pierre-bouckson/GameGirl/PCB/jlcpcb/production_files/BOM-PCB-dos.csv

Comment | Designator | Footprint | LCSC | Quantity
1.5kΩ | R3 | R_0402 | C25867 | 1
100kΩ | R7,R8,R10,R38 | R_0402 | C25741 | 4
100nF | C5,C6,C7,C8,C9,C10,C11,C12,C13,C14,C15,C16,C17,C20,C23,C24,C30,C31,C32,C33,C34,C35,C36,C40,C41,C42,C43,C44,C45,C46,C50 | C_0402 | C1525 | 31
100Ω | R37 | R_0402 | C25076 | 1
10kΩ | R6,R9,R22,R23,R24,R25,R26,R43 | R_0402 | C25744 | 8
10uF | C1,C2,C3,C4,C47 | C_0603 | C19702 | 5
15Ω | R44 | R_0603 | C22810 | 1
1N4148W | D5 | D_SOD-123 | C81598 | 1
1kΩ | R4,R5,R20,R21 | R_0402 | C11702 | 4
1uF | C19 | C_0603 | C15849 | 1
1uF | C53 | C_0805 | C28323 | 1
2.2uF | C21,C22 | C_0603 | C23630 | 2
220nF | C54 | C_0402 | C16772 | 1
4.7uF | C18,C51,C52 | C_0603 | C19666 | 3
5.1kΩ | R1,R2 | R_0402 | C25905 | 2
600Ω@100MHz | FB1 | FB_0603 | C1002 | 1
AO3400A | Q2 | Q_SOT-23 | C20917 | 1
AO3401A | Q1,Q3 | Q_SOT-23 | C15127 | 2
AP2112K-3.3TRG1 | U2 | SOT-25-5_L2.9-W1.6-P0.95-LS2.8-BL | C51118 | 1
B5819W | D1,D4 | D_SOD-123 | C64885 | 2
BATT JST-PH 2 mm | J2 | CONN-SMD_P2.00_S2B-PH-SM4-TB-LF-SN | C295747 | 1
DT024CTFT | J6 | CONN-SMD_FH12-45S-0.5SH-55 | C3168432 | 1
IS42S16400J-7TLI | U5 | TSOP-54_L22.2-W10.2-P0.80-LS11.8-BL | C2979137 | 1
MLT-8530 | BZ1 | BUZ-SMD_4P-L8.5-W8.5-P8.50-BR | C94599 | 1
ON/OFF | SW1 | SW-TH_MSK12C02 | C431540 | 1
Rouge : en charge | D2 | D_0603 | C2286 | 1
STM32F429ZIT6 | U3 | LQFP-144_20x20mm_P0.5mm | C84808 | 1
SWPA4030S100MT | L1 | IND-SMD_L4.0-W4.0 | C38117 | 1
TP4056 | U1 | ESOP-8_L4.9-W3.9-P1.27-LS6.0-BL-EP | C16581 | 1
TPS61165DBVR | U6 | SOT-23-6_L2.9-W1.6-P0.95-LS2.8-BR | C58756 | 1
USB-C 16P | J1 | TYPE-C-SMD_HX-TYPE-C-16PIN | C2927039 | 1
Vert : chargée | D3 | D_0805 | C2297 | 1
