pierre-bouckson/GameGirl/boitier/assemblage.step

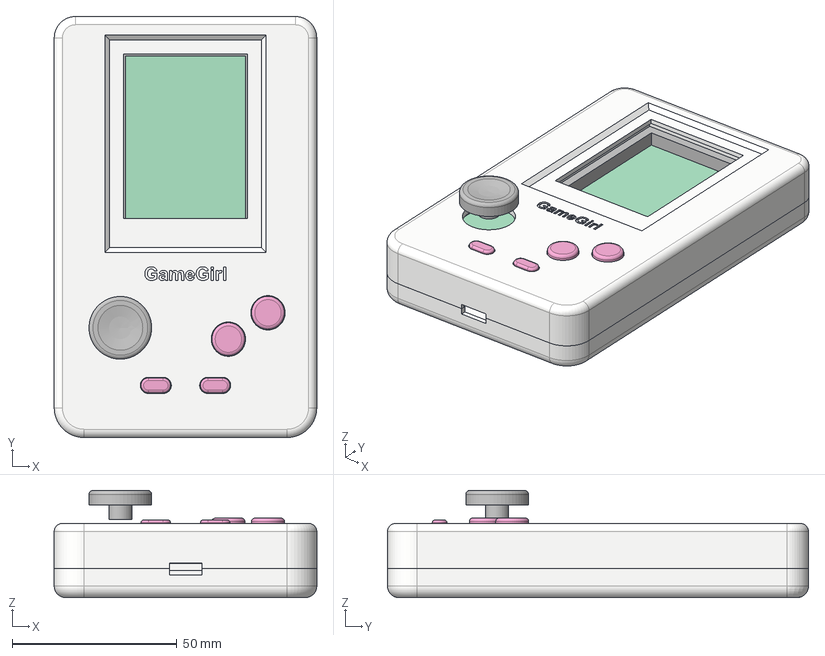
[picture p1: CAD file, 2026-11-11]
boitier/assemblage.step
79.6 x 127.6 x 32.5 mm
coque_avant_part
coque_arriere_part
cale_ecran_part
pcb_part
capuchon_A_part
capuchon_B_part
capuchon_SELECT_part
capuchon_START_part
capuchon_joystick_part
