pierre-bouckson/GameGirl/boitier/cale_ecran.step

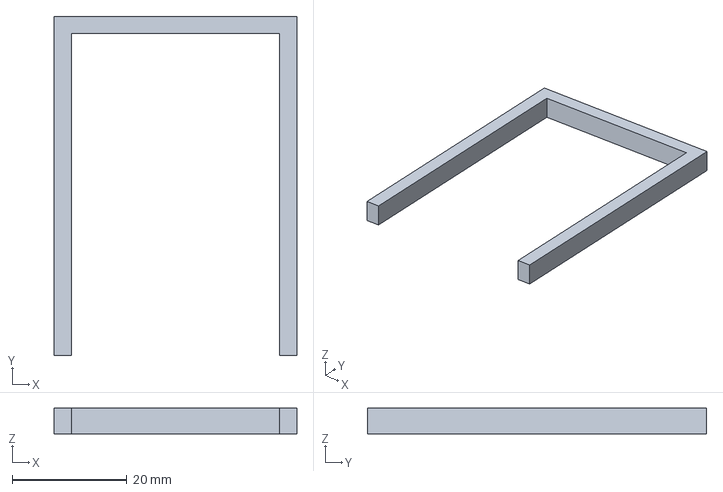
[picture p2: CAD file, 2026-11-11]
boitier/cale_ecran.step
42.3 x 59.1 x 4.50 mm
