pierre-bouckson/GameGirl/boitier/coque_arriere_bambu_lab.3mf

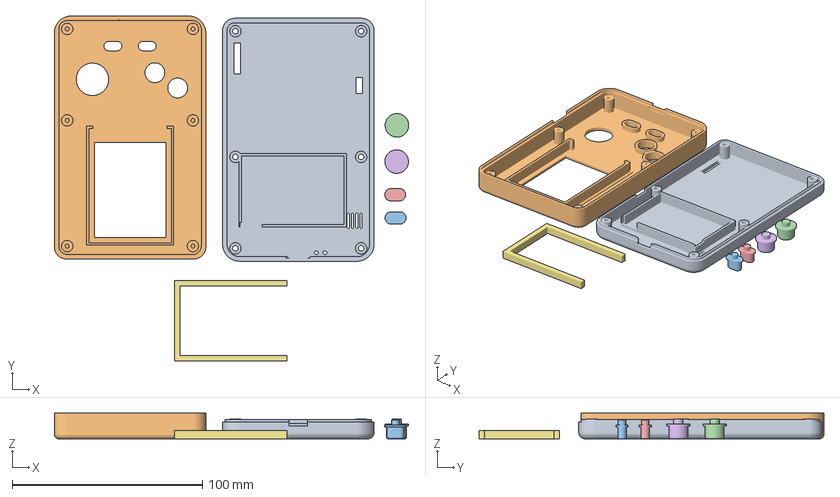
[picture p3: CAD file, 2026-11-11]
boitier/coque_arriere_bambu_lab.3mf
186.1 x 181.1 x 13.6 mm
coque_arriere.stl
coque_avant.stl
capuchon_start_select.stl x 2
capuchon_AB.stl x 2
cale_ecran.stl
