pierre-bouckson/GameGirl/boitier/capuchon_AB.step

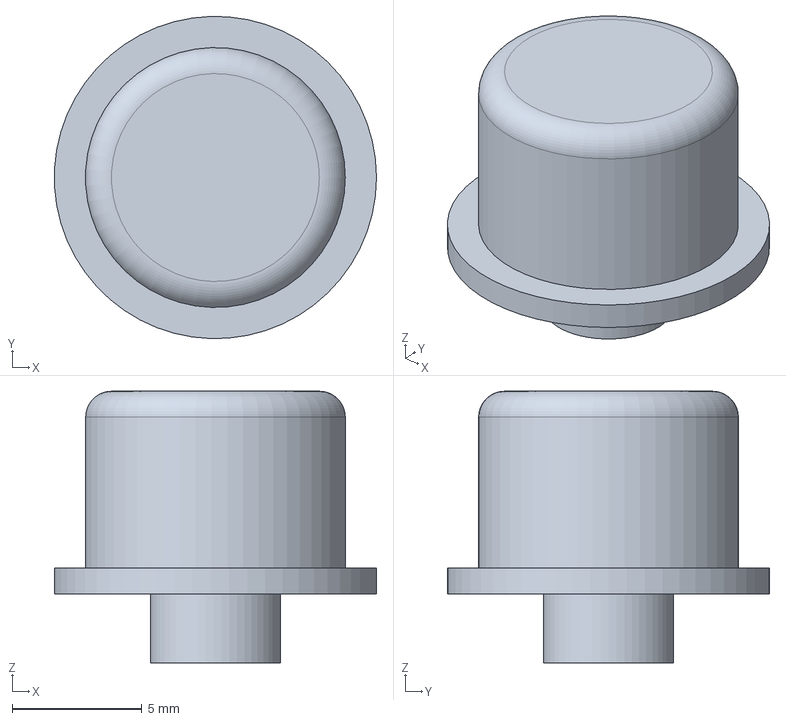
[picture p4: CAD file, 2026-11-11]
boitier/capuchon_AB.step
12.4 x 12.4 x 10.4 mm
