pierre-bouckson/GameGirl/boitier/capuchon_start_select.step

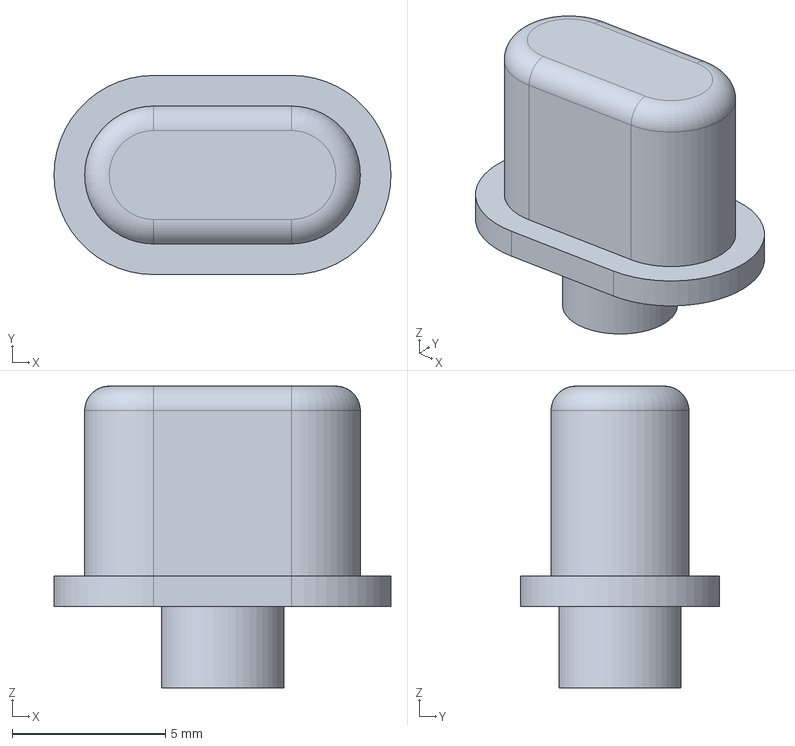
[picture p5: CAD file, 2026-11-11]
boitier/capuchon_start_select.step
11.0 x 6.50 x 9.85 mm
