pierre-bouckson/GameGirl/boitier/coque_avant.step

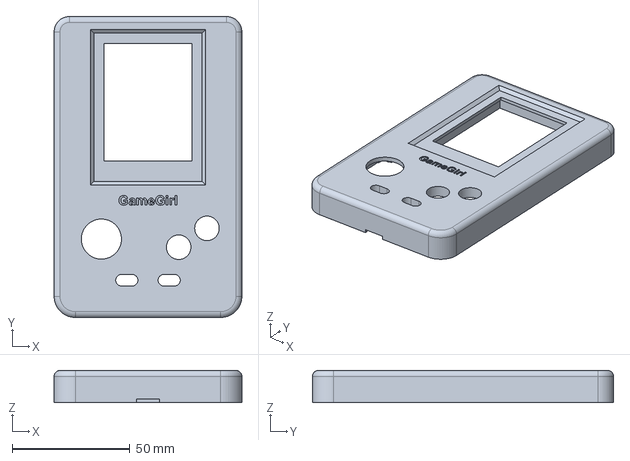
[picture p6: CAD file, 2026-11-11]
boitier/coque_avant.step
79.6 x 127.6 x 13.6 mm
