pierre-bouckson/GameGirl/boitier/coque_arriere.step

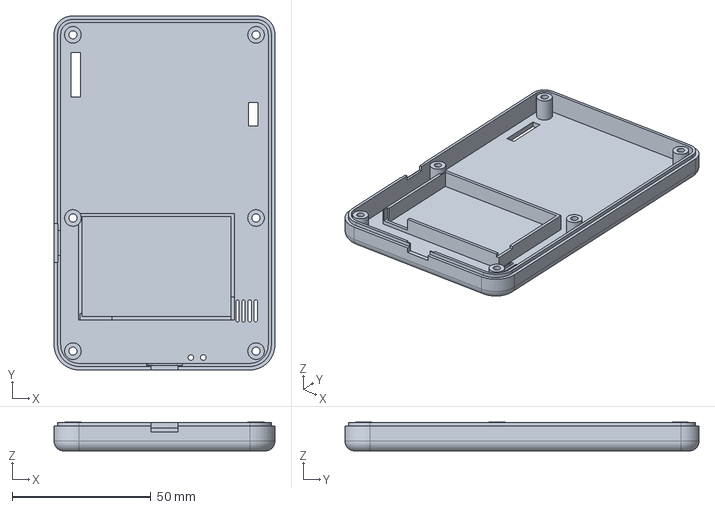
[picture p7: CAD file, 2026-11-11]
boitier/coque_arriere.step
79.6 x 127.6 x 10.4 mm
