pierre-bouckson/GameGirl/boitier/capuchon_joystick.step

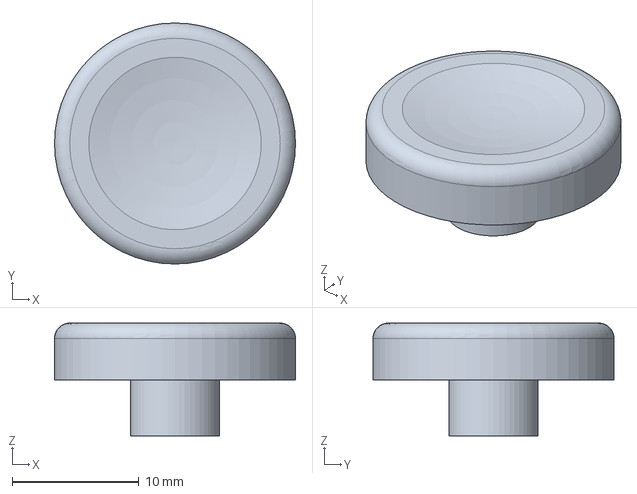
[picture p8: CAD file, 2026-11-11]
boitier/capuchon_joystick.step
19.0 x 19.0 x 8.90 mm
