pierre-bouckson/GameGirl/(list of files, cad)

Other CAD files:
boitier/cale_ecran.stl
boitier/capuchon_AB.stl
boitier/capuchon_joystick.stl
boitier/capuchon_start_select.stl
boitier/coque_arriere.stl
boitier/coque_avant.stl
