pierre-bouckson/GameGirl/PCB/PCB.kicad_pcb

## KiCad design PCB/PCB.kicad_pcb (2026-11-11)

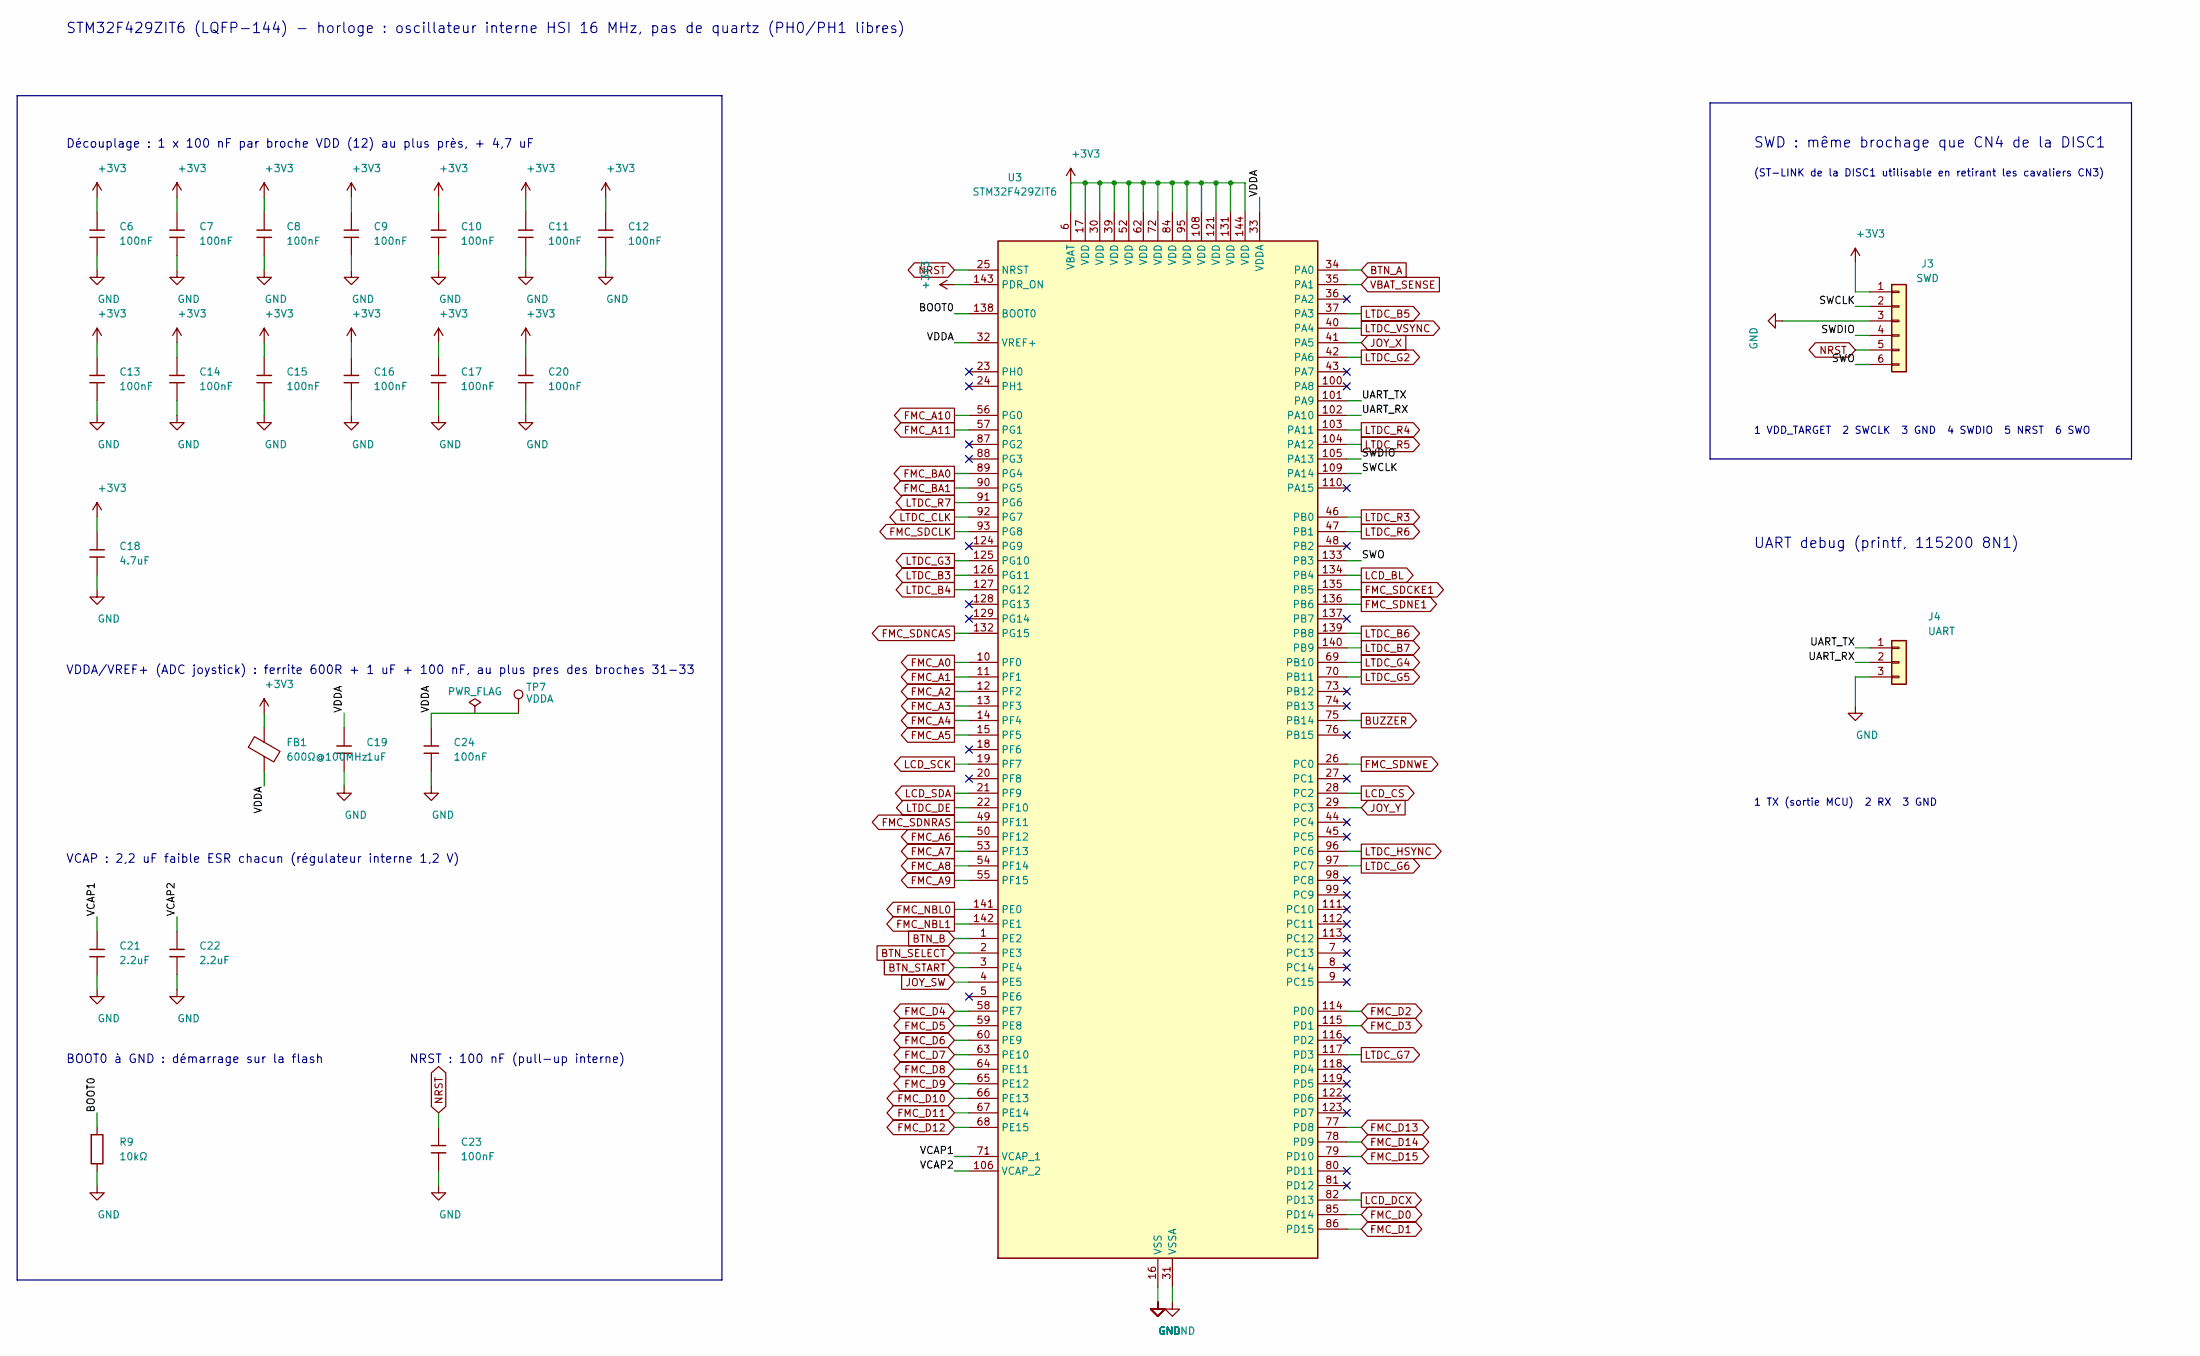
[picture p9: schematic mcu.kicad_sch, GameGirl - MCU]

Parts:
C6, C7, C8, C9, C10, C11, C12, C13, C14, C15, C16, C17, C20, C23, C24: 100nF; C_0402; LCSC C1525
C18: 4.7uF; C_0603; LCSC C19666
C19: 1uF; C_0603; LCSC C15849
C21, C22: 2.2uF; C_0603; LCSC C23630
FB1: 600Ω@100MHz; FB_0603; LCSC C1002
J3: SWD; PinHeader_1x06_P2.54mm_Vertical
J4: UART; PinHeader_1x03_P2.54mm_Vertical
R9: 10kΩ; R_0402; LCSC C25744
TP7: VDDA; TestPoint_Pad_D1.5mm
U3: STM32F429ZIT6; LQFP-144_20x20mm_P0.5mm; LCSC C84808

Connections:
+3V3: C6.1, C7.1, C8.1, C9.1, C10.1, C11.1, C12.1, C13.1, C14.1, C15.1, C16.1, C17.1, C18.1, C20.1, FB1.1, J3.1, U3.6 (VBAT), U3.17 (VDD), U3.30 (VDD), U3.39 (VDD), U3.52 (VDD), U3.62 (VDD), U3.72 (VDD), U3.84 (VDD), U3.95 (VDD), U3.108 (VDD), U3.121 (VDD), U3.131 (VDD), U3.143 (PDR_ON), U3.144 (VDD); also elsewhere on the board
/MCU/BOOT0: R9.1, U3.138 (BOOT0)
/MCU/SWCLK: J3.2, U3.109 (PA14)
/MCU/SWDIO: J3.4, U3.105 (PA13)
/MCU/SWO: J3.6, U3.133 (PB3)
/MCU/UART_RX: J4.2, U3.102 (PA10)
/MCU/UART_TX: J4.1, U3.101 (PA9)
/MCU/VCAP1: C21.1, U3.71 (VCAP_1)
/MCU/VCAP2: C22.1, U3.106 (VCAP_2)
/MCU/VDDA: C19.1, C24.1, FB1.2, TP7.1, U3.32 (VREF+), U3.33 (VDDA)
BTN_A: U3.34 (PA0); also elsewhere on the board
BTN_B: U3.1 (PE2); also elsewhere on the board
BTN_SELECT: U3.2 (PE3); also elsewhere on the board
BTN_START: U3.3 (PE4); also elsewhere on the board
BUZZER: U3.75 (PB14); also elsewhere on the board
FMC_A0: U3.10 (PF0); also elsewhere on the board
FMC_A1: U3.11 (PF1); also elsewhere on the board
FMC_A2: U3.12 (PF2); also elsewhere on the board
FMC_A3: U3.13 (PF3); also elsewhere on the board
FMC_A4: U3.14 (PF4); also elsewhere on the board
FMC_A5: U3.15 (PF5); also elsewhere on the board
FMC_A6: U3.50 (PF12); also elsewhere on the board
FMC_A7: U3.53 (PF13); also elsewhere on the board
FMC_A8: U3.54 (PF14); also elsewhere on the board
FMC_A9: U3.55 (PF15); also elsewhere on the board
FMC_A10: U3.56 (PG0); also elsewhere on the board
FMC_A11: U3.57 (PG1); also elsewhere on the board
FMC_BA0: U3.89 (PG4); also elsewhere on the board
FMC_BA1: U3.90 (PG5); also elsewhere on the board
FMC_D0: U3.85 (PD14); also elsewhere on the board
FMC_D1: U3.86 (PD15); also elsewhere on the board
FMC_D2: U3.114 (PD0); also elsewhere on the board
FMC_D3: U3.115 (PD1); also elsewhere on the board
FMC_D4: U3.58 (PE7); also elsewhere on the board
FMC_D5: U3.59 (PE8); also elsewhere on the board
FMC_D6: U3.60 (PE9); also elsewhere on the board
FMC_D7: U3.63 (PE10); also elsewhere on the board
FMC_D8: U3.64 (PE11); also elsewhere on the board
FMC_D9: U3.65 (PE12); also elsewhere on the board
FMC_D10: U3.66 (PE13); also elsewhere on the board
FMC_D11: U3.67 (PE14); also elsewhere on the board
FMC_D12: U3.68 (PE15); also elsewhere on the board
FMC_D13: U3.77 (PD8); also elsewhere on the board
FMC_D14: U3.78 (PD9); also elsewhere on the board
FMC_D15: U3.79 (PD10); also elsewhere on the board
FMC_NBL0: U3.141 (PE0); also elsewhere on the board
FMC_NBL1: U3.142 (PE1); also elsewhere on the board
FMC_SDCKE1: U3.135 (PB5); also elsewhere on the board
FMC_SDCLK: U3.93 (PG8); also elsewhere on the board
FMC_SDNCAS: U3.132 (PG15); also elsewhere on the board
FMC_SDNE1: U3.136 (PB6); also elsewhere on the board
FMC_SDNRAS: U3.49 (PF11); also elsewhere on the board
FMC_SDNWE: U3.26 (PC0); also elsewhere on the board
GND: C6.2, C7.2, C8.2, C9.2, C10.2, C11.2, C12.2, C13.2, C14.2, C15.2, C16.2, C17.2, C18.2, C19.2, C20.2, C21.2, C22.2, C23.2, C24.2, J3.3, J4.3, R9.2, U3.16 (VSS), U3.31 (VSSA), U3.38 (VSS), U3.51 (VSS), U3.61 (VSS), U3.83 (VSS), U3.94 (VSS), U3.107 (VSS), U3.120 (VSS), U3.130 (VSS); also elsewhere on the board
JOY_SW: U3.4 (PE5); also elsewhere on the board
JOY_X: U3.41 (PA5); also elsewhere on the board
JOY_Y: U3.29 (PC3); also elsewhere on the board
LCD_BL: U3.134 (PB4); also elsewhere on the board
LCD_CS: U3.28 (PC2); also elsewhere on the board
LCD_DCX: U3.82 (PD13); also elsewhere on the board
LCD_SCK: U3.19 (PF7); also elsewhere on the board
LCD_SDA: U3.21 (PF9); also elsewhere on the board
LTDC_B3: U3.126 (PG11); also elsewhere on the board
LTDC_B4: U3.127 (PG12); also elsewhere on the board
LTDC_B5: U3.37 (PA3); also elsewhere on the board
LTDC_B6: U3.139 (PB8); also elsewhere on the board
LTDC_B7: U3.140 (PB9); also elsewhere on the board
LTDC_CLK: U3.92 (PG7); also elsewhere on the board
LTDC_DE: U3.22 (PF10); also elsewhere on the board
LTDC_G2: U3.42 (PA6); also elsewhere on the board
LTDC_G3: U3.125 (PG10); also elsewhere on the board
LTDC_G4: U3.69 (PB10); also elsewhere on the board
LTDC_G5: U3.70 (PB11); also elsewhere on the board
LTDC_G6: U3.97 (PC7); also elsewhere on the board
LTDC_G7: U3.117 (PD3); also elsewhere on the board
LTDC_HSYNC: U3.96 (PC6); also elsewhere on the board
LTDC_R3: U3.46 (PB0); also elsewhere on the board
LTDC_R4: U3.103 (PA11); also elsewhere on the board
LTDC_R5: U3.104 (PA12); also elsewhere on the board
LTDC_R6: U3.47 (PB1); also elsewhere on the board
LTDC_R7: U3.91 (PG6); also elsewhere on the board
LTDC_VSYNC: U3.40 (PA4); also elsewhere on the board
NRST: C23.1, J3.5, U3.25 (NRST); also elsewhere on the board
VBAT_SENSE: U3.35 (PA1); also elsewhere on the board

Notes on the sheet:
(ST-LINK de la DISC1 utilisable en retirant les cavaliers CN3)
BOOT0 à GND : démarrage sur la flash
1 VDD_TARGET 2 SWCLK 3 GND 4 SWDIO 5 NRST 6 SWO
SWD : même brochage que CN4 de la DISC1
NRST : 100 nF (pull-up interne)
Découplage : 1 x 100 nF par broche VDD (12) au plus près, + 4,7 uF
VCAP : 2,2 uF faible ESR chacun (régulateur interne 1,2 V)
STM32F429ZIT6 (LQFP-144) - horloge : oscillateur interne HSI 16 MHz, pas de quartz (PH0/PH1 libres)
VDDA/VREF+ (ADC joystick) : ferrite 600R + 1 uF + 100 nF, au plus pres des broches 31-33
UART debug (printf, 115200 8N1)
1 TX (sortie MCU) 2 RX 3 GND

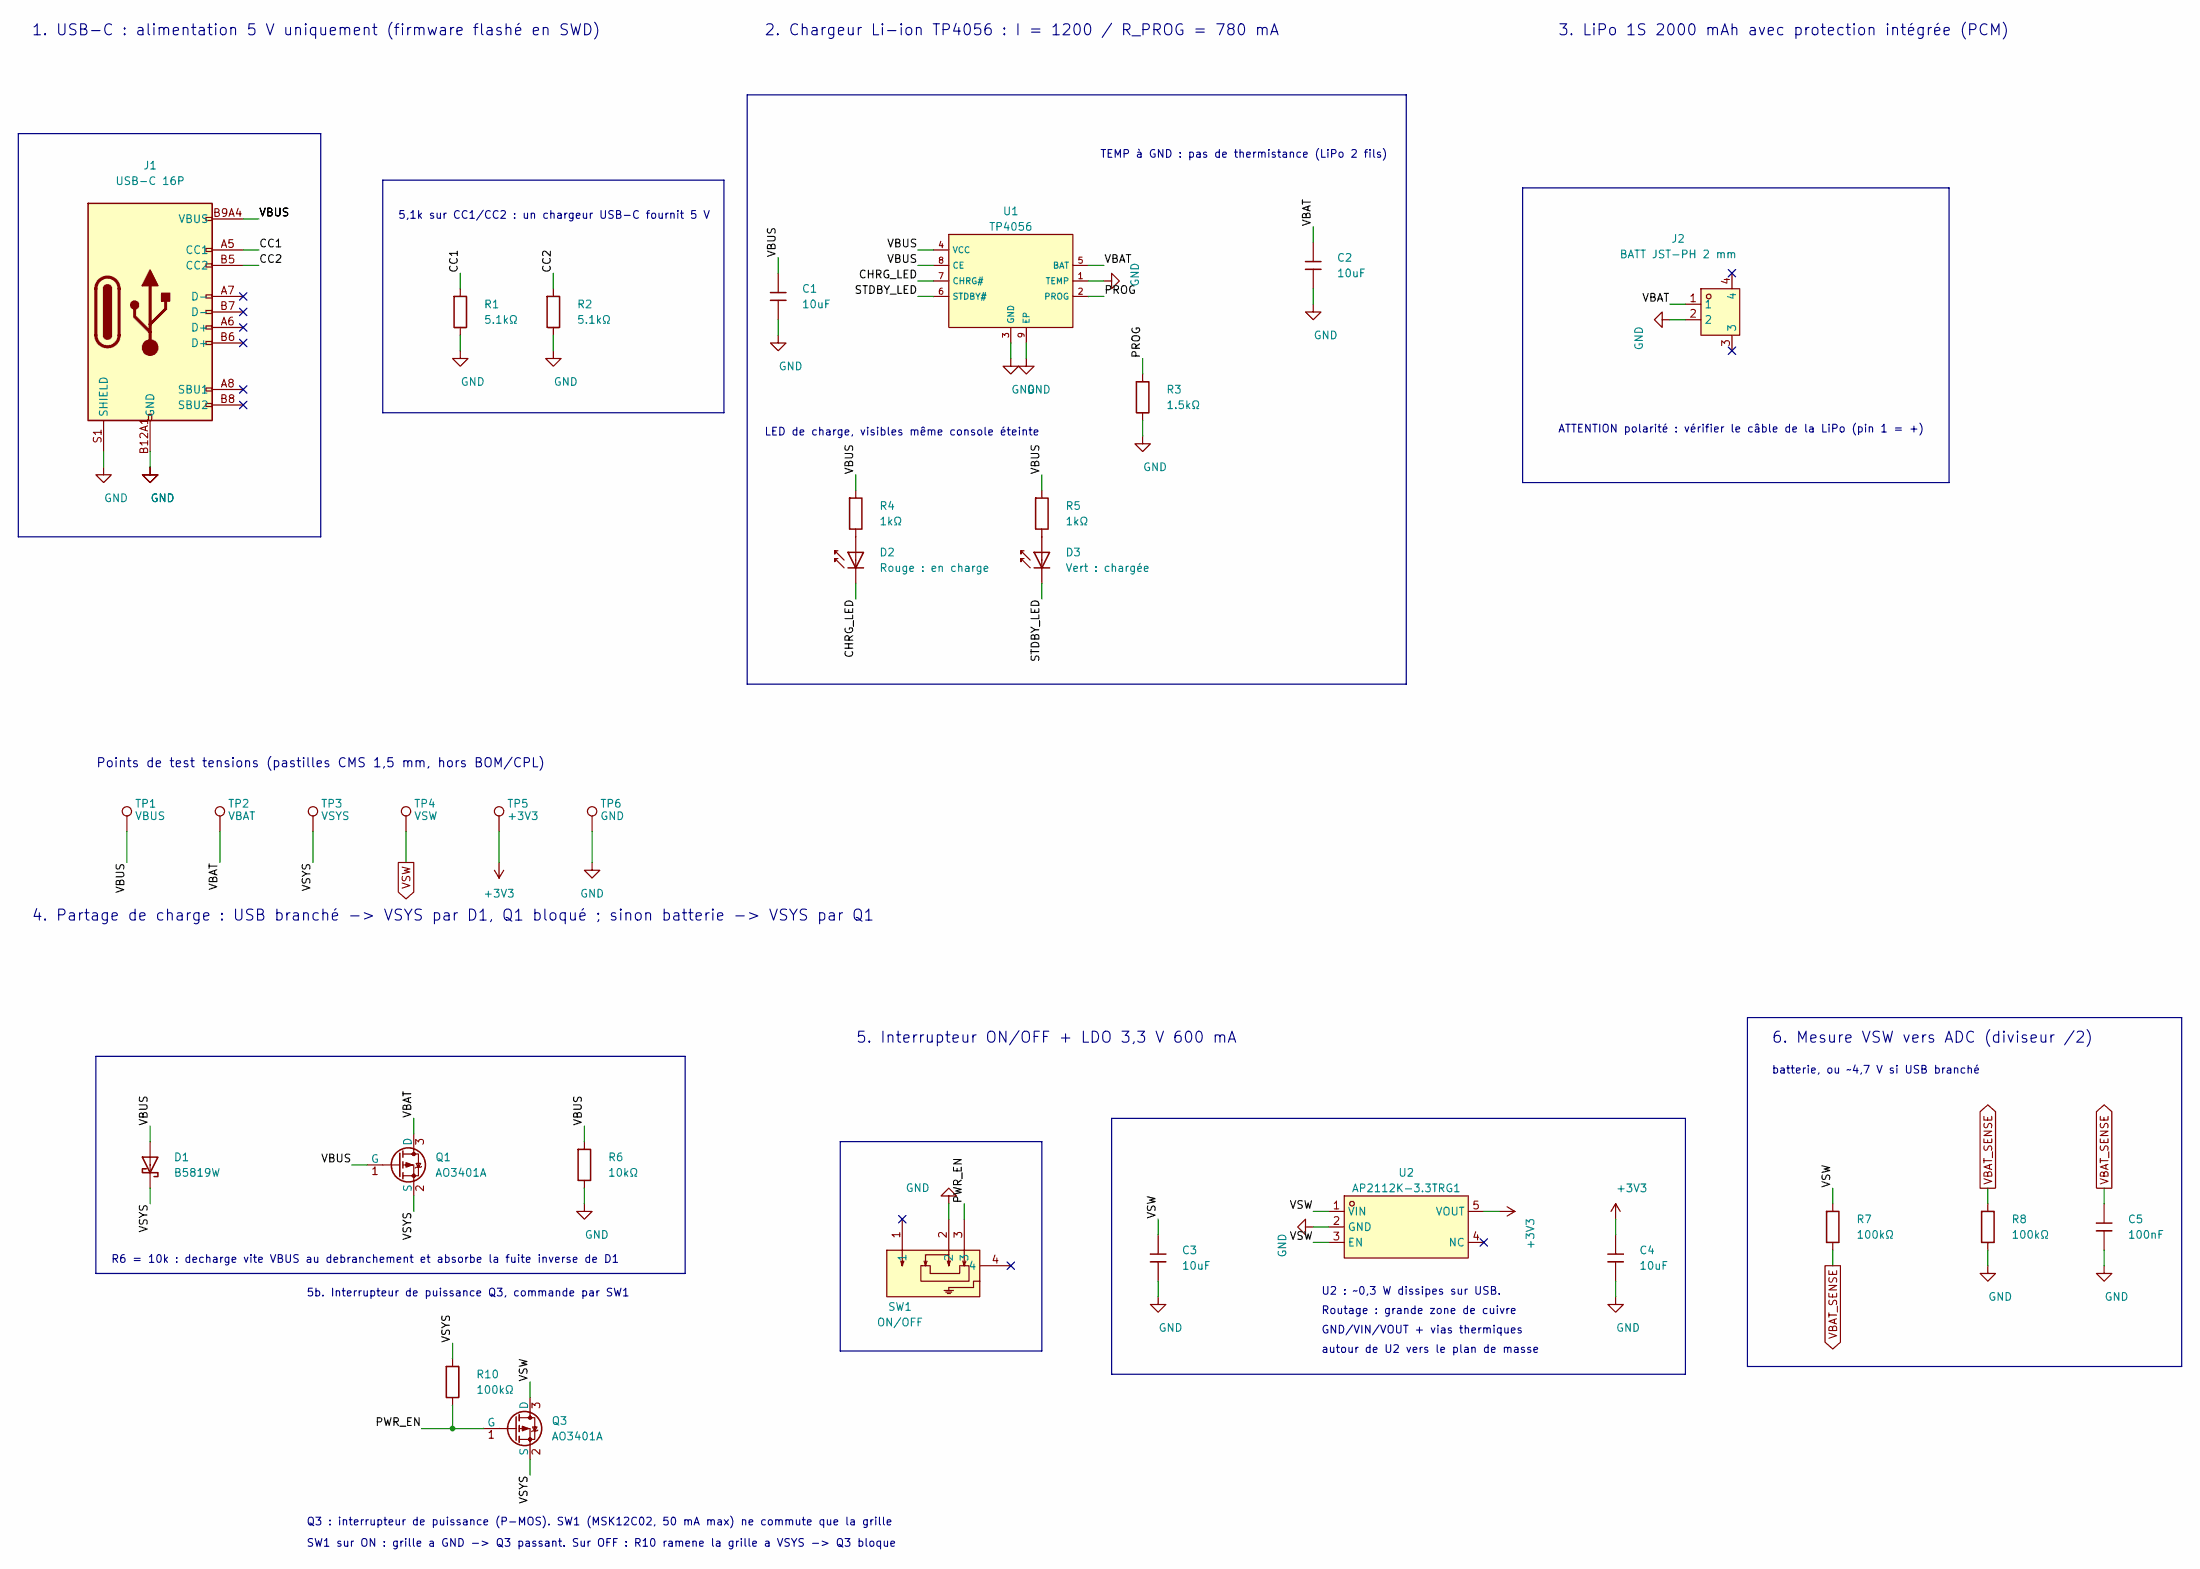
[picture p10: schematic power.kicad_sch, GameGirl - Alimentation]

Parts:
C1, C2, C3, C4: 10uF; C_0603; LCSC C19702
C5: 100nF; C_0402; LCSC C1525
D1: B5819W; D_SOD-123; LCSC C64885
D2: Rouge : en charge; D_0603; LCSC C2286
D3: Vert : chargée; D_0805; LCSC C2297
J1: USB-C 16P; TYPE-C-SMD_HX-TYPE-C-16PIN; LCSC C2927039
J2: BATT JST-PH 2 mm; CONN-SMD_P2.00_S2B-PH-SM4-TB-LF-SN; LCSC C295747
Q1, Q3: AO3401A; Q_SOT-23; LCSC C15127
R1, R2: 5.1kΩ; R_0402; LCSC C25905
R3: 1.5kΩ; R_0402; LCSC C25867
R4, R5: 1kΩ; R_0402; LCSC C11702
R6: 10kΩ; R_0402; LCSC C25744
R7, R8, R10: 100kΩ; R_0402; LCSC C25741
SW1: ON/OFF; SW-TH_MSK12C02; LCSC C431540
TP1: VBUS; TestPoint_Pad_D1.5mm
TP2: VBAT; TestPoint_Pad_D1.5mm
TP3: VSYS; TestPoint_Pad_D1.5mm
TP4: VSW; TestPoint_Pad_D1.5mm
TP5: +3V3; TestPoint_Pad_D1.5mm
TP6: GND; TestPoint_Pad_D1.5mm
U1: TP4056; ESOP-8_L4.9-W3.9-P1.27-LS6.0-BL-EP; LCSC C16581
U2: AP2112K-3.3TRG1; SOT-25-5_L2.9-W1.6-P0.95-LS2.8-BL; LCSC C51118

Connections:
+3V3: C4.1, TP5.1, U2.5 (VOUT); also elsewhere on the board
/Alimentation/CC1: J1.A5 (CC1), R1.1
/Alimentation/CC2: J1.B5 (CC2), R2.1
/Alimentation/CHRG_LED: D2.1, U1.7 (CHRG#)
/Alimentation/PROG: R3.1, U1.2 (PROG)
/Alimentation/PWR_EN: Q3.1 (G), R10.2, SW1.3
/Alimentation/STDBY_LED: D3.1, U1.6 (STDBY#)
/Alimentation/VBAT: C2.1, J2.1, Q1.3 (D), TP2.1, U1.5 (BAT)
/Alimentation/VBUS: C1.1, D1.2, J1.A9B4 (VBUS), J1.B9A4 (VBUS), Q1.1 (G), R4.1, R5.1, R6.1, TP1.1, U1.4 (VCC), U1.8 (CE)
/Alimentation/VSYS: D1.1, Q1.2 (S), Q3.2 (S), R10.1, TP3.1
GND: C1.2, C2.2, C3.2, C4.2, C5.2, J1.A12B1 (GND), J1.B12A1 (GND), J1.S1 (SHIELD), J2.2, R1.2, R2.2, R3.2, R6.2, R8.2, SW1.2, TP6.1, U1.1 (TEMP), U1.3 (GND), U1.9 (EP), U2.2 (GND); also elsewhere on the board
unnamed: D2.2, R4.2
unnamed: D3.2, R5.2
VBAT_SENSE: C5.1, R7.2, R8.1; also elsewhere on the board
VSW: C3.1, Q3.3 (D), R7.1, TP4.1, U2.1 (VIN), U2.3 (EN); also elsewhere on the board

Notes on the sheet:
3. LiPo 1S 2000 mAh avec protection intégrée (PCM)
5. Interrupteur ON/OFF + LDO 3,3 V 600 mA
TEMP à GND : pas de thermistance (LiPo 2 fils)
ATTENTION polarité : vérifier le câble de la LiPo (pin 1 = +)
4. Partage de charge : USB branché -> VSYS par D1, Q1 bloqué ; sinon batterie -> VSYS par Q1
5,1k sur CC1/CC2 : un chargeur USB-C fournit 5 V
1. USB-C : alimentation 5 V uniquement (firmware flashé en SWD)
LED de charge, visibles même console éteinte
batterie, ou ~4,7 V si USB branché
6. Mesure VSW vers ADC (diviseur /2)
2. Chargeur Li-ion TP4056 : I = 1200 / R_PROG = 780 mA
Points de test tensions (pastilles CMS 1,5 mm, hors BOM/CPL)
U2 : ~0,3 W dissipes sur USB.
Routage : grande zone de cuivre
GND/VIN/VOUT + vias thermiques
autour de U2 vers le plan de masse
5b. Interrupteur de puissance Q3, commande par SW1
Q3 : interrupteur de puissance (P-MOS). SW1 (MSK12C02, 50 mA max) ne commute que la grille
SW1 sur ON : grille a GND -> Q3 passant. Sur OFF : R10 ramene la grille a VSYS -> Q3 bloque
R6 = 10k : decharge vite VBUS au debranchement et absorbe la fuite inverse de D1

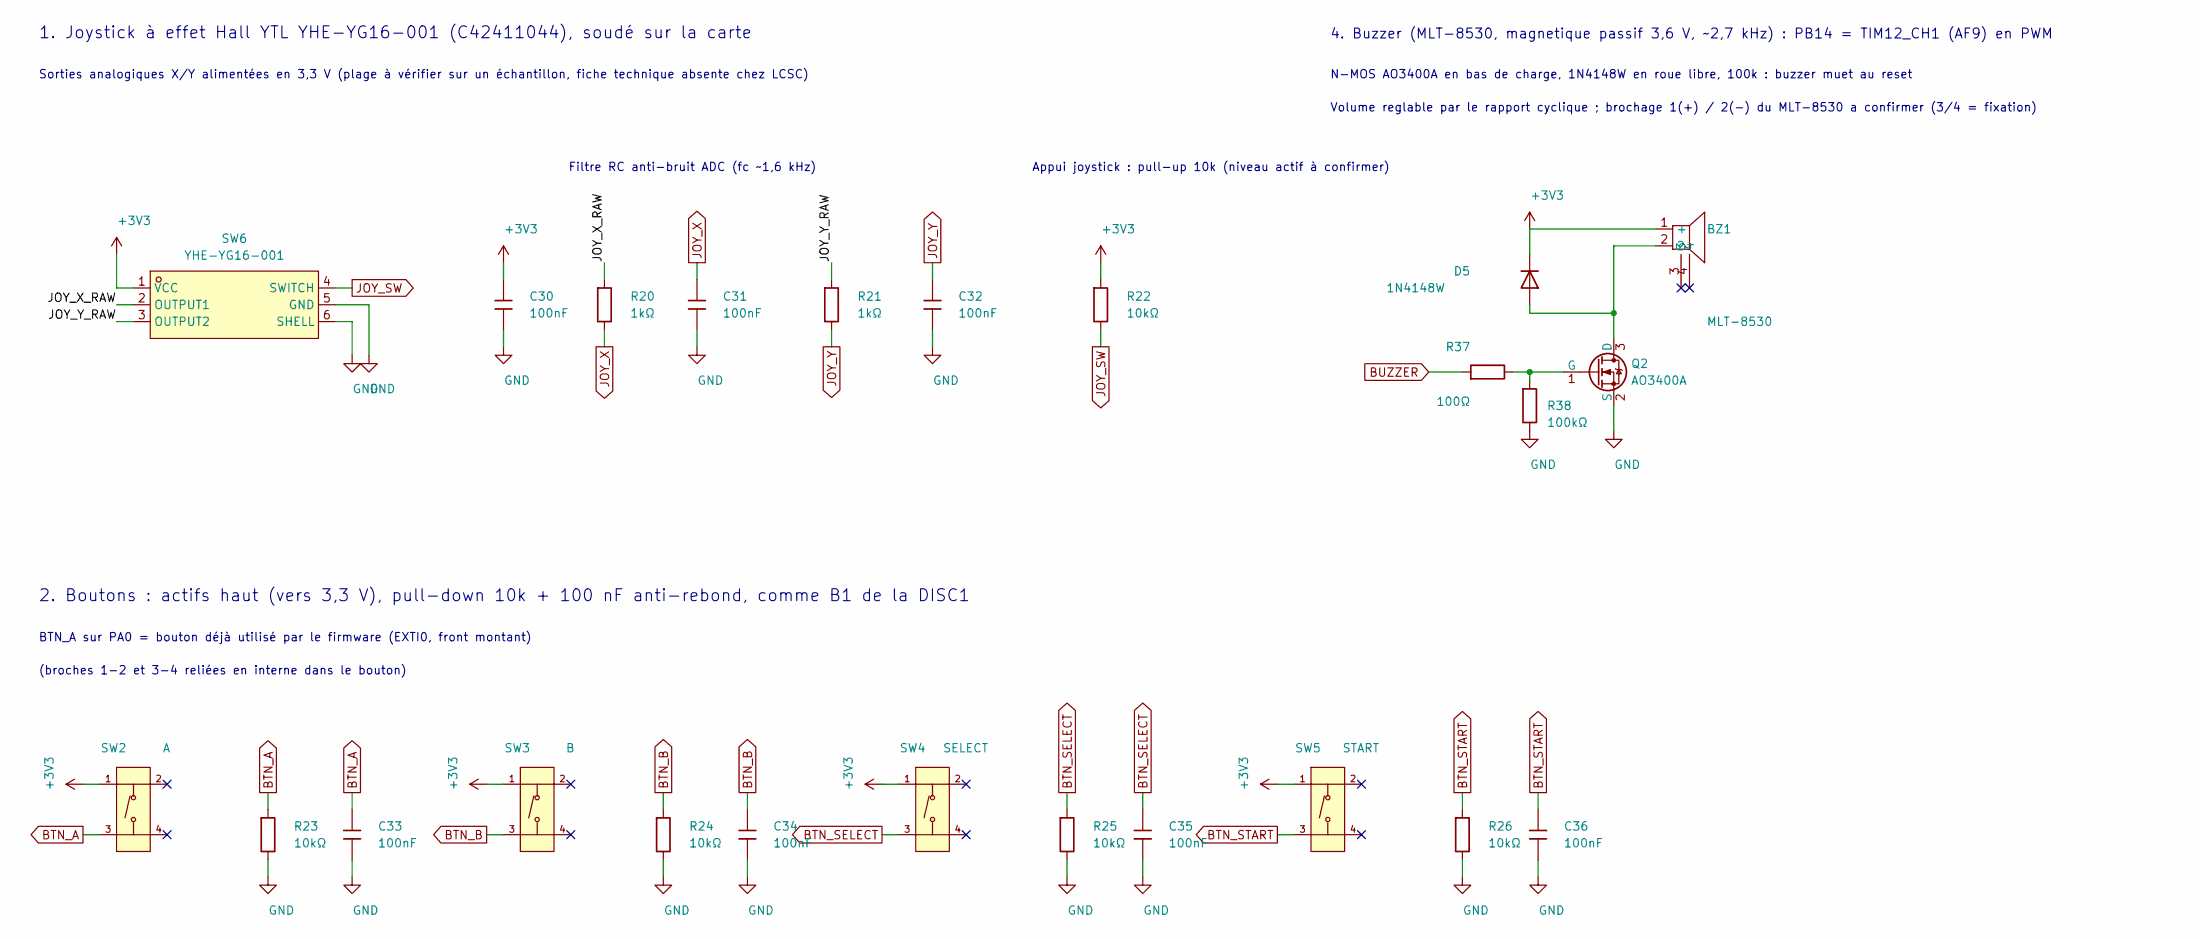
[picture p11: schematic inputs.kicad_sch, GameGirl - Boutons]

Parts:
BZ1: MLT-8530; BUZ-SMD_4P-L8.5-W8.5-P8.50-BR; LCSC C94599
C30, C31, C32, C33, C34, C35, C36: 100nF; C_0402; LCSC C1525
D5: 1N4148W; D_SOD-123; LCSC C81598
Q2: AO3400A; Q_SOT-23; LCSC C20917
R20, R21: 1kΩ; R_0402; LCSC C11702
R22, R23, R24, R25, R26: 10kΩ; R_0402; LCSC C25744
R37: 100Ω; R_0402; LCSC C25076
R38: 100kΩ; R_0402; LCSC C25741
SW2: A; SW-SMD_4P-L5.1-W5.1-P3.70-LS6.5-TL-2; LCSC C318884
SW3: B; SW-SMD_4P-L5.1-W5.1-P3.70-LS6.5-TL-2; LCSC C318884
SW4: SELECT; SW-SMD_4P-L5.1-W5.1-P3.70-LS6.5-TL-2; LCSC C318884
SW5: START; SW-SMD_4P-L5.1-W5.1-P3.70-LS6.5-TL-2; LCSC C318884
SW6: YHE-YG16-001; SW-TH_YHE-YG16-001-SH1B166A1; LCSC C42411044

Connections:
+3V3: BZ1.1 (+), C30.1, D5.1, R22.1, SW2.1 (A), SW3.1 (A), SW4.1 (A), SW5.1 (A), SW6.1 (VCC); also elsewhere on the board
/Boutons/JOY_X_RAW: R20.1, SW6.2 (OUTPUT1)
/Boutons/JOY_Y_RAW: R21.1, SW6.3 (OUTPUT2)
BTN_A: C33.1, R23.1, SW2.3 (C); also elsewhere on the board
BTN_B: C34.1, R24.1, SW3.3 (C); also elsewhere on the board
BTN_SELECT: C35.1, R25.1, SW4.3 (C); also elsewhere on the board
BTN_START: C36.1, R26.1, SW5.3 (C); also elsewhere on the board
BUZZER: R37.1; also elsewhere on the board
GND: C30.2, C31.2, C32.2, C33.2, C34.2, C35.2, C36.2, Q2.2 (S), R23.2, R24.2, R25.2, R26.2, R38.2, SW6.5 (GND), SW6.6 (SHELL); also elsewhere on the board
JOY_SW: R22.2, SW6.4 (SWITCH); also elsewhere on the board
JOY_X: C31.1, R20.2; also elsewhere on the board
JOY_Y: C32.1, R21.2; also elsewhere on the board
unnamed: BZ1.2, D5.2, Q2.3 (D)
unnamed: Q2.1 (G), R37.2, R38.1

Notes on the sheet:
2. Boutons : actifs haut (vers 3,3 V), pull-down 10k + 100 nF anti-rebond, comme B1 de la DISC1
1. Joystick à effet Hall YTL YHE-YG16-001 (C42411044), soudé sur la carte
(broches 1-2 et 3-4 reliées en interne dans le bouton)
Sorties analogiques X/Y alimentées en 3,3 V (plage à vérifier sur un échantillon, fiche technique absente chez LCSC)
BTN_A sur PA0 = bouton déjà utilisé par le firmware (EXTI0, front montant)
Appui joystick : pull-up 10k (niveau actif à confirmer)
Filtre RC anti-bruit ADC (fc ~1,6 kHz)
4. Buzzer (MLT-8530, magnetique passif 3,6 V, ~2,7 kHz) : PB14 = TIM12_CH1 (AF9) en PWM
N-MOS AO3400A en bas de charge, 1N4148W en roue libre, 100k : buzzer muet au reset
Volume reglable par le rapport cyclique ; brochage 1(+) / 2(-) du MLT-8530 a confirmer (3/4 = fixation)

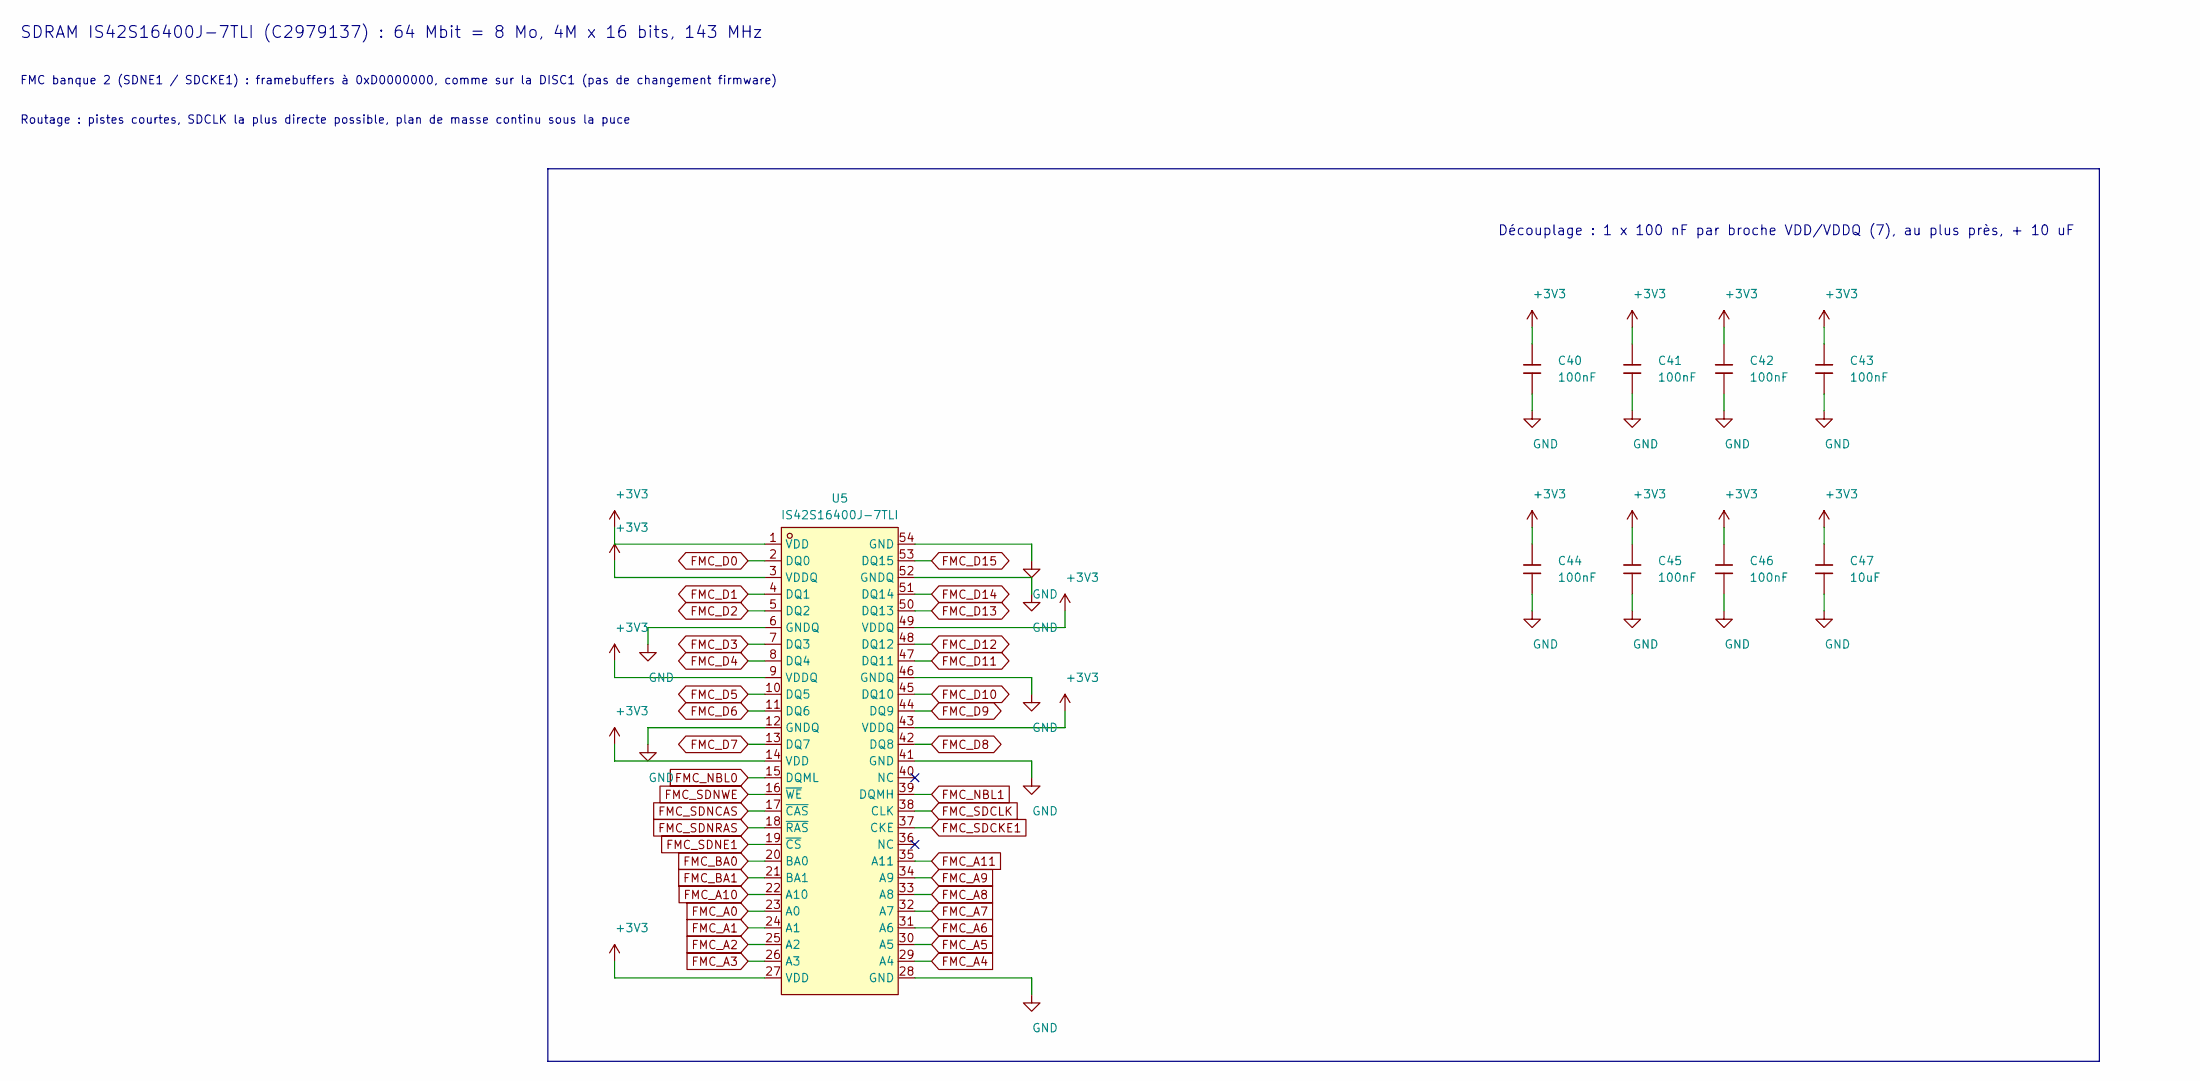
[picture p12: schematic sdram.kicad_sch, GameGirl - SDRAM]

Parts:
C40, C41, C42, C43, C44, C45, C46: 100nF; C_0402; LCSC C1525
C47: 10uF; C_0603; LCSC C19702
U5: IS42S16400J-7TLI; TSOP-54_L22.2-W10.2-P0.80-LS11.8-BL; LCSC C2979137

Connections:
+3V3: C40.1, C41.1, C42.1, C43.1, C44.1, C45.1, C46.1, C47.1, U5.1 (VDD), U5.3 (VDDQ), U5.9 (VDDQ), U5.14 (VDD), U5.27 (VDD), U5.43 (VDDQ), U5.49 (VDDQ); also elsewhere on the board
FMC_A0: U5.23 (A0); also elsewhere on the board
FMC_A1: U5.24 (A1); also elsewhere on the board
FMC_A2: U5.25 (A2); also elsewhere on the board
FMC_A3: U5.26 (A3); also elsewhere on the board
FMC_A4: U5.29 (A4); also elsewhere on the board
FMC_A5: U5.30 (A5); also elsewhere on the board
FMC_A6: U5.31 (A6); also elsewhere on the board
FMC_A7: U5.32 (A7); also elsewhere on the board
FMC_A8: U5.33 (A8); also elsewhere on the board
FMC_A9: U5.34 (A9); also elsewhere on the board
FMC_A10: U5.22 (A10); also elsewhere on the board
FMC_A11: U5.35 (A11); also elsewhere on the board
FMC_BA0: U5.20 (BA0); also elsewhere on the board
FMC_BA1: U5.21 (BA1); also elsewhere on the board
FMC_D0: U5.2 (DQ0); also elsewhere on the board
FMC_D1: U5.4 (DQ1); also elsewhere on the board
FMC_D2: U5.5 (DQ2); also elsewhere on the board
FMC_D3: U5.7 (DQ3); also elsewhere on the board
FMC_D4: U5.8 (DQ4); also elsewhere on the board
FMC_D5: U5.10 (DQ5); also elsewhere on the board
FMC_D6: U5.11 (DQ6); also elsewhere on the board
FMC_D7: U5.13 (DQ7); also elsewhere on the board
FMC_D8: U5.42 (DQ8); also elsewhere on the board
FMC_D9: U5.44 (DQ9); also elsewhere on the board
FMC_D10: U5.45 (DQ10); also elsewhere on the board
FMC_D11: U5.47 (DQ11); also elsewhere on the board
FMC_D12: U5.48 (DQ12); also elsewhere on the board
FMC_D13: U5.50 (DQ13); also elsewhere on the board
FMC_D14: U5.51 (DQ14); also elsewhere on the board
FMC_D15: U5.53 (DQ15); also elsewhere on the board
FMC_NBL0: U5.15 (DQML); also elsewhere on the board
FMC_NBL1: U5.39 (DQMH); also elsewhere on the board
FMC_SDCKE1: U5.37 (CKE); also elsewhere on the board
FMC_SDCLK: U5.38 (CLK); also elsewhere on the board
FMC_SDNCAS: U5.17 (~CAS); also elsewhere on the board
FMC_SDNE1: U5.19 (~CS); also elsewhere on the board
FMC_SDNRAS: U5.18 (~RAS); also elsewhere on the board
FMC_SDNWE: U5.16 (~WE); also elsewhere on the board
GND: C40.2, C41.2, C42.2, C43.2, C44.2, C45.2, C46.2, C47.2, U5.6 (GNDQ), U5.12 (GNDQ), U5.28 (GND), U5.41 (GND), U5.46 (GNDQ), U5.52 (GNDQ), U5.54 (GND); also elsewhere on the board

Notes on the sheet:
Routage : pistes courtes, SDCLK la plus directe possible, plan de masse continu sous la puce
SDRAM IS42S16400J-7TLI (C2979137) : 64 Mbit = 8 Mo, 4M x 16 bits, 143 MHz
Découplage : 1 x 100 nF par broche VDD/VDDQ (7), au plus près, + 10 uF
FMC banque 2 (SDNE1 / SDCKE1) : framebuffers à 0xD0000000, comme sur la DISC1 (pas de changement firmware)
