pierre-bouckson/GameGirl/PCB/PCB.kicad_pcb

## KiCad design PCB/PCB.kicad_pcb (continued)

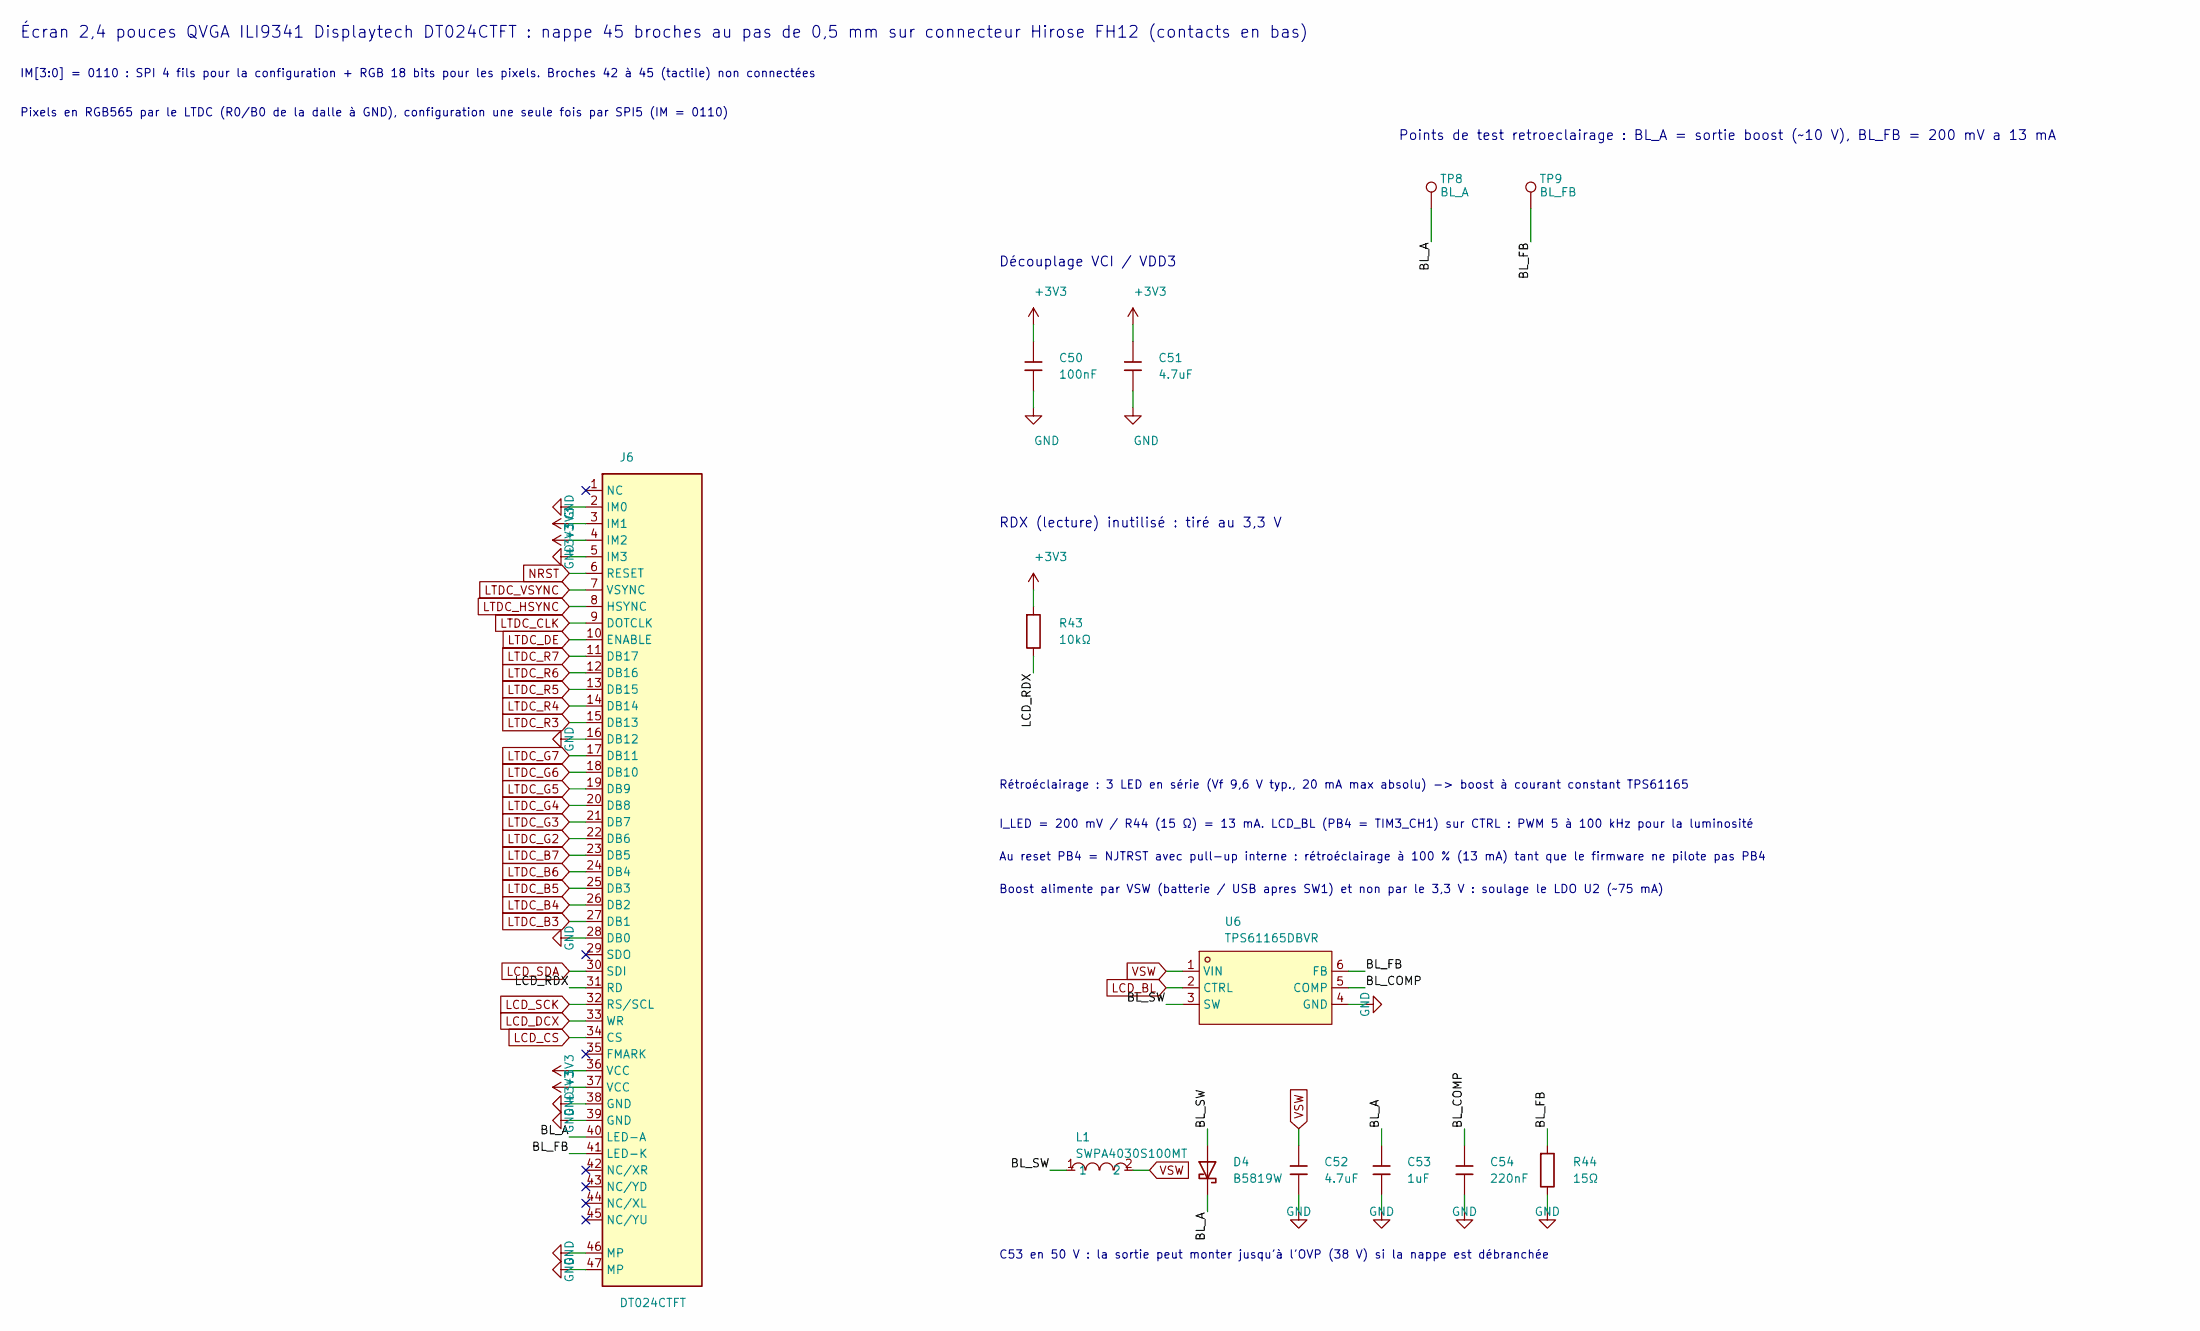
[picture p13: schematic lcd.kicad_sch, GameGirl - Ecran]

Parts:
C50: 100nF; C_0402; LCSC C1525
C51: 4.7uF; C_0603; LCSC C19666
C52: 4.7uF; C_0603; Voltage Rated 16V; Tolerance ±10%; Part CL10A475KO8NNNC; LCSC C19666
C53: 1uF; C_0805; Voltage Rated 50V; Tolerance ±10%; Part CL21B105KBFNNNE; LCSC C28323
C54: 220nF; C_0402; Voltage Rated 16V; Tolerance ±10%; Part CL05B224KO5NNNC; LCSC C16772
D4: B5819W; D_SOD-123; Forward Voltage (Vf@If) 900mV@3A; Reverse Voltage (Vr) 40V; Part B5819W; LCSC C64885
J6: DT024CTFT; CONN-SMD_FH12-45S-0.5SH-55; MPN FH12-45S-0.5SH(55); LCSC C3168432
L1: SWPA4030S100MT; IND-SMD_L4.0-W4.0; MPN SWPA4030S100MT; LCSC Part C38117
R43: 10kΩ; R_0402; LCSC C25744
R44: 15Ω; R_0603; LCSC C22810
TP8: BL_A; TestPoint_Pad_D1.5mm
TP9: BL_FB; TestPoint_Pad_D1.5mm
U6: TPS61165DBVR; SOT-23-6_L2.9-W1.6-P0.95-LS2.8-BR; MPN TPS61165DBVR; LCSC Part C58756

Connections:
+3V3: C50.1, C51.1, J6.3 (IM1), J6.4 (IM2), J6.36 (VCC), J6.37 (VCC), R43.1; also elsewhere on the board
/Ecran/BL_A: C53.1, D4.1, J6.40 (LED-A), TP8.1
/Ecran/BL_COMP: C54.1, U6.5 (COMP)
/Ecran/BL_FB: J6.41 (LED-K), R44.1, TP9.1, U6.6 (FB)
/Ecran/BL_SW: D4.2, L1.1, U6.3 (SW)
/Ecran/LCD_RDX: J6.31 (RD), R43.2
GND: C50.2, C51.2, C52.2, C53.2, C54.2, J6.2 (IM0), J6.5 (IM3), J6.16 (DB12), J6.28 (DB0), J6.38 (GND), J6.39 (GND), J6.46 (MP), J6.47 (MP), R44.2, U6.4 (GND); also elsewhere on the board
LCD_BL: U6.2 (CTRL); also elsewhere on the board
LCD_CS: J6.34 (CS); also elsewhere on the board
LCD_DCX: J6.33 (WR); also elsewhere on the board
LCD_SCK: J6.32 (RS/SCL); also elsewhere on the board
LCD_SDA: J6.30 (SDI); also elsewhere on the board
LTDC_B3: J6.27 (DB1); also elsewhere on the board
LTDC_B4: J6.26 (DB2); also elsewhere on the board
LTDC_B5: J6.25 (DB3); also elsewhere on the board
LTDC_B6: J6.24 (DB4); also elsewhere on the board
LTDC_B7: J6.23 (DB5); also elsewhere on the board
LTDC_CLK: J6.9 (DOTCLK); also elsewhere on the board
LTDC_DE: J6.10 (ENABLE); also elsewhere on the board
LTDC_G2: J6.22 (DB6); also elsewhere on the board
LTDC_G3: J6.21 (DB7); also elsewhere on the board
LTDC_G4: J6.20 (DB8); also elsewhere on the board
LTDC_G5: J6.19 (DB9); also elsewhere on the board
LTDC_G6: J6.18 (DB10); also elsewhere on the board
LTDC_G7: J6.17 (DB11); also elsewhere on the board
LTDC_HSYNC: J6.8 (HSYNC); also elsewhere on the board
LTDC_R3: J6.15 (DB13); also elsewhere on the board
LTDC_R4: J6.14 (DB14); also elsewhere on the board
LTDC_R5: J6.13 (DB15); also elsewhere on the board
LTDC_R6: J6.12 (DB16); also elsewhere on the board
LTDC_R7: J6.11 (DB17); also elsewhere on the board
LTDC_VSYNC: J6.7 (VSYNC); also elsewhere on the board
NRST: J6.6 (RESET); also elsewhere on the board
VSW: C52.1, L1.2, U6.1 (VIN); also elsewhere on the board

Notes on the sheet:
Pixels en RGB565 par le LTDC (R0/B0 de la dalle à GND), configuration une seule fois par SPI5 (IM = 0110)
Écran 2,4 pouces QVGA ILI9341 Displaytech DT024CTFT : nappe 45 broches au pas de 0,5 mm sur connecteur Hirose FH12 (contacts en bas)
Découplage VCI / VDD3
IM[3:0] = 0110 : SPI 4 fils pour la configuration + RGB 18 bits pour les pixels. Broches 42 à 45 (tactile) non connectées
RDX (lecture) inutilisé : tiré au 3,3 V
Rétroéclairage : 3 LED en série (Vf 9,6 V typ., 20 mA max absolu) -> boost à courant constant TPS61165
I_LED = 200 mV / R44 (15 Ω) = 13 mA. LCD_BL (PB4 = TIM3_CH1) sur CTRL : PWM 5 à 100 kHz pour la luminosité
Au reset PB4 = NJTRST avec pull-up interne : rétroéclairage à 100 % (13 mA) tant que le firmware ne pilote pas PB4
C53 en 50 V : la sortie peut monter jusqu'à l'OVP (38 V) si la nappe est débranchée
Points de test retroeclairage : BL_A = sortie boost (~10 V), BL_FB = 200 mV a 13 mA
Boost alimente par VSW (batterie / USB apres SW1) et non par le 3,3 V : soulage le LDO U2 (~75 mA)

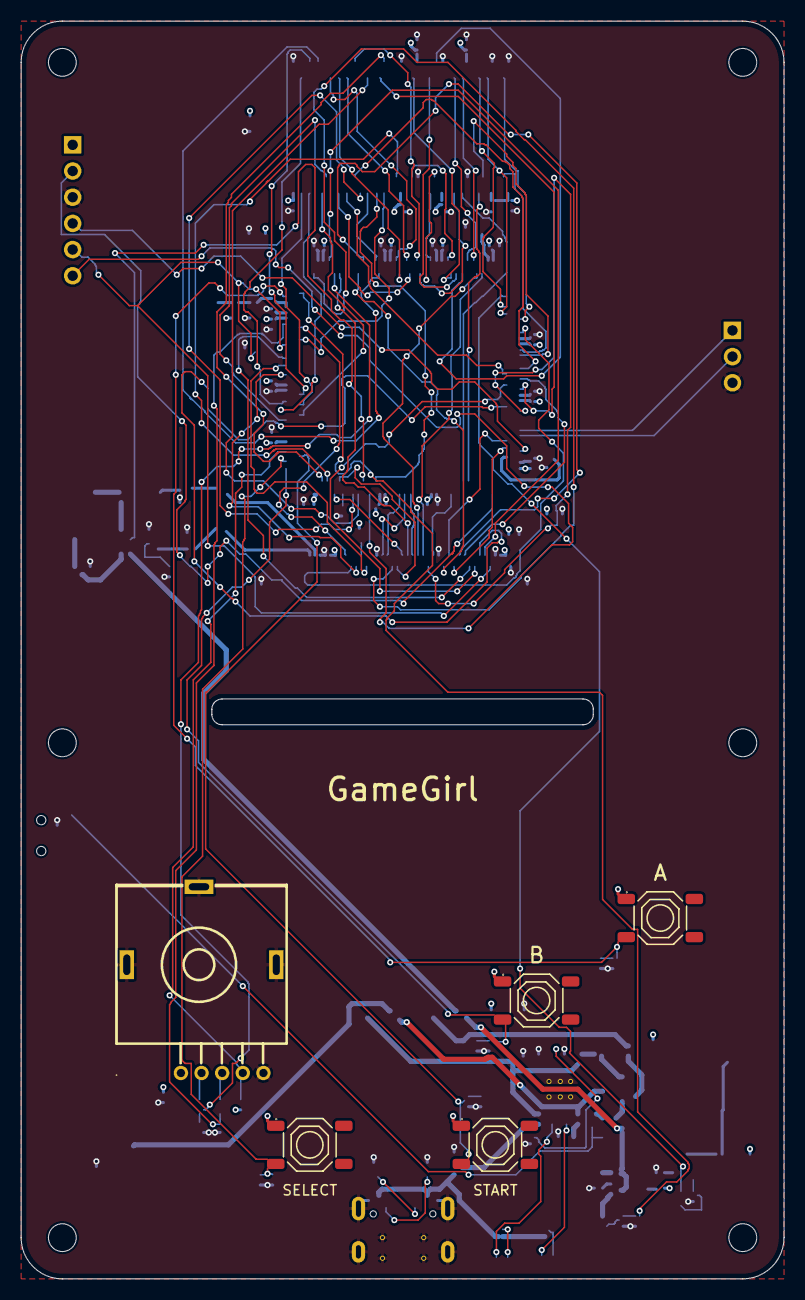
[picture p14: board PCB.kicad_pcb from above]

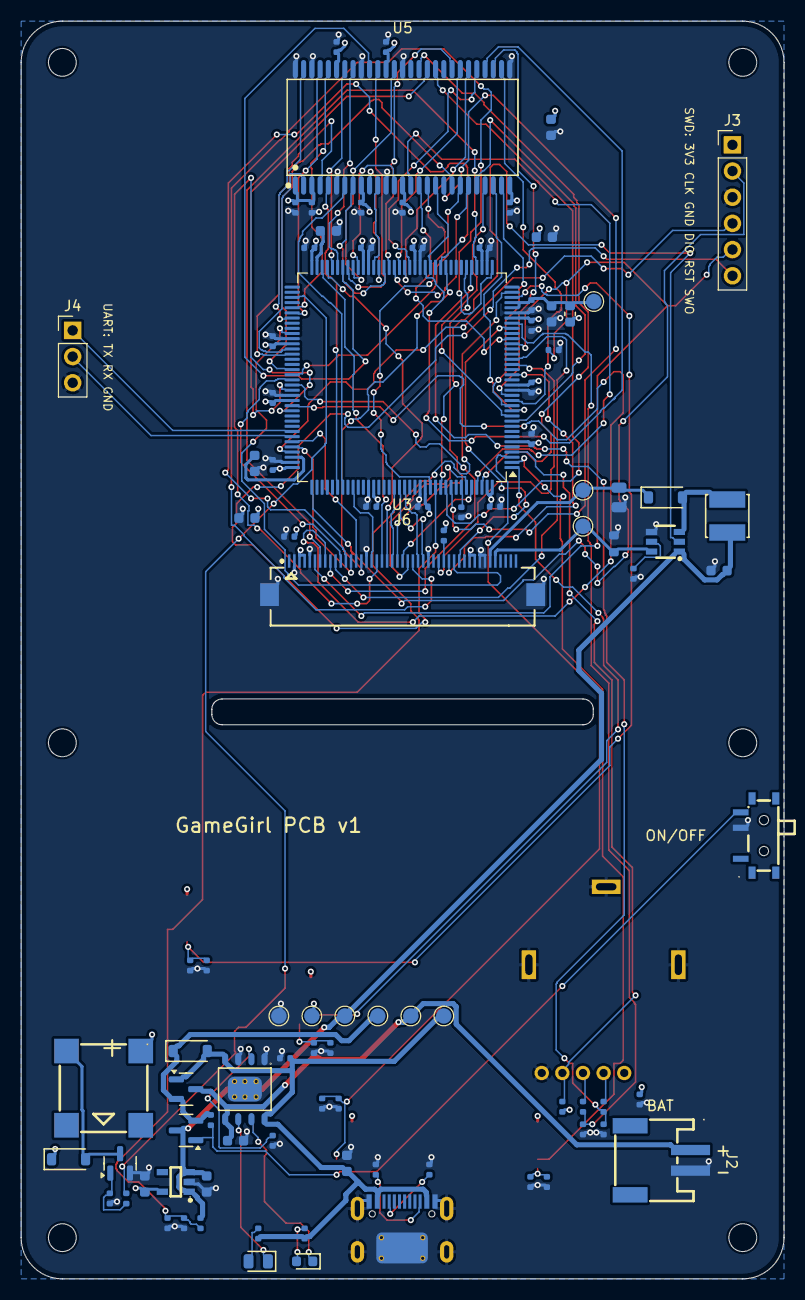
[picture p15: board PCB.kicad_pcb from below]

Board: 4 copper layers, 74.0 x 122.0 mm, 107 parts (96 on the bottom side), 105 nets.

Other parts of the board:
H1, H2, H3, H4, H5, H6: M2.5; MountingHole_2.7mm_M2.5
