pierre-bouckson/GameGirl/firmware/Src/main.c

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
/* Includes ------------------------------------------------------------------*/
#include "main.h"

/* USER CODE BEGIN Includes */
#include <stdio.h>
#include <stdbool.h>
#include "display.h"
#include "menu.h"
#include "input.h"

/* USER CODE END Includes */

ADC_HandleTypeDef hadc1;
DMA_HandleTypeDef hdma_adc1;

I2C_HandleTypeDef hi2c3;

LTDC_HandleTypeDef hltdc;

SPI_HandleTypeDef hspi5;

UART_HandleTypeDef huart1;

SDRAM_HandleTypeDef hsdram2;

/* USER CODE BEGIN PV */

double tab[30][40] = {0};

volatile uint16_t joy_adc[2];   /* [0] = X (canal 5), [1] = Y (canal 13) */

volatile uint8_t button_pressed = 0;

/* USER CODE END PV */

void SystemClock_Config(void);
static void MX_GPIO_Init(void);
static void MX_DMA_Init(void);
static void MX_LTDC_Init(void);
static void MX_SPI5_Init(void);
static void MX_FMC_Init(void);
static void MX_I2C3_Init(void);
static void MX_ADC1_Init(void);
static void MX_USART1_UART_Init(void);
/* USER CODE BEGIN 0 */

#define SDRAM_TIMEOUT 0xFFFF

/* Séquence d'init JEDEC de la SDRAM IS42S16400J (FMC bank 2) */
static void SDRAM_InitSequence(SDRAM_HandleTypeDef *hsdram)
{
  FMC_SDRAM_CommandTypeDef cmd = {0};

  /* 1. Activer l'horloge SDRAM */
  cmd.CommandMode            = FMC_SDRAM_CMD_CLK_ENABLE;
  cmd.CommandTarget          = FMC_SDRAM_CMD_TARGET_BANK2;
  cmd.AutoRefreshNumber      = 1;
  cmd.ModeRegisterDefinition = 0;
  HAL_SDRAM_SendCommand(hsdram, &cmd, SDRAM_TIMEOUT);

  HAL_Delay(1);  /* >= 100 us requis */

  /* 2. Precharge All */
  cmd.CommandMode = FMC_SDRAM_CMD_PALL;
  HAL_SDRAM_SendCommand(hsdram, &cmd, SDRAM_TIMEOUT);

  /* 3. Auto-refresh x8 */
  cmd.CommandMode       = FMC_SDRAM_CMD_AUTOREFRESH_MODE;
  cmd.AutoRefreshNumber = 8;
  HAL_SDRAM_SendCommand(hsdram, &cmd, SDRAM_TIMEOUT);

  /* 4. Load Mode Register : burst 1, séquentiel, CAS 3, write burst single */
  cmd.CommandMode            = FMC_SDRAM_CMD_LOAD_MODE;
  cmd.AutoRefreshNumber      = 1;
  cmd.ModeRegisterDefinition = 0x0230;
  HAL_SDRAM_SendCommand(hsdram, &cmd, SDRAM_TIMEOUT);

  /* 5. Refresh : 64 ms / 4096 lignes = 15.62 us ; 15.62 us * 64 MHz - 20 = 980 */
  HAL_SDRAM_ProgramRefreshRate(hsdram, 980);
}

/* USER CODE END 0 */

/**
  * @brief  The application entry point.
  * @retval int
  */
int main(void)
{

  /* MCU Configuration--------------------------------------------------------*/

  /* Reset of all peripherals, Initializes the Flash interface and the Systick. */
  HAL_Init();

  /* Configure the system clock */
  SystemClock_Config();

  /* Initialize all configured peripherals */
  MX_GPIO_Init();
  MX_DMA_Init();
  MX_LTDC_Init();
  MX_SPI5_Init();
  MX_FMC_Init();
  MX_I2C3_Init();
  MX_ADC1_Init();
  MX_USART1_UART_Init();
  /* USER CODE BEGIN 2 */

  /* printf non bufferisé : chaque caractère part tout de suite, même sans \n */
  setvbuf(stdout, NULL, _IONBF, 0);

  SDRAM_InitSequence(&hsdram2);

  HAL_ADC_Start_DMA(&hadc1, (uint32_t *)joy_adc, 2);

  display_init();

  print_menu();

  joy_mv_t joy = get_joy();

  joy_mv_t selection = selection_joy(joy);


  /* USER CODE END 2 */

  /* Infinite loop */
  /* USER CODE BEGIN WHILE */
  while (1)
  {
    if (button_pressed)
    {
      button_pressed = 0;
      HAL_GPIO_TogglePin(GPIOG, GPIO_PIN_13);
      start_game();
      print_menu();
    }

    selection = selection_joy();

    if(new_selection())
    {
      printf("selection X : %d    selection Y = %d \r\n", selection.x, selection.y);
      menu_move((joy_mv_t){selection.x, selection.y});
      print_menu();
    }

    //printf("X = %u  %d  Y = %u  %d\r\n", value_x, selection.x, value_y, selection.y);
    HAL_Delay(100);
    /* USER CODE END WHILE */

    /* USER CODE BEGIN 3 */
  }
  /* USER CODE END 3 */
}

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
/* USER CODE BEGIN 4 */

/* Redirige printf vers l'UART1 (appelé par _write dans syscalls.c) */
int __io_putchar(int ch)
{
  uint8_t c = ch;
  HAL_UART_Transmit(&huart1, &c, 1, HAL_MAX_DELAY);
  return ch;
}

void HAL_GPIO_EXTI_Callback(uint16_t GPIO_Pin)
{
  if (GPIO_Pin == GPIO_PIN_0)
  {
    button_pressed = 1;
  }
}

/* USER CODE END 4 */
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
