pierre-bouckson/GameGirl/firmware/GameGirl.ioc

Mcu.UserName=STM32F429ZITx
PA0/WKUP.Signal=GPXTI0
PA10.Signal=USART1_RX
PA11.Signal=LTDC_R4
PA12.Signal=LTDC_R5
PA3.Signal=LTDC_B5
PA4.Signal=LTDC_VSYNC
PA5.Signal=ADCx_IN5
PA6.Signal=LTDC_G2
PA8.Signal=I2C3_SCL
PA9.Signal=USART1_TX
PB0.Signal=LTDC_R3
PB1.Signal=LTDC_R6
PB10.Signal=LTDC_G4
PB11.Signal=LTDC_G5
PB5.Signal=FMC_SDCKE1
PB6.Signal=FMC_SDNE1
PB8.Signal=LTDC_B6
PB9.Signal=LTDC_B7
PC0.Signal=FMC_SDNWE
PC3.Signal=ADCx_IN13
PC6.Signal=LTDC_HSYNC
PC7.Signal=LTDC_G6
PC9.Signal=I2C3_SDA
PD0.Signal=FMC_D2_DA2
PD1.Signal=FMC_D3_DA3
PD10.Signal=FMC_D15_DA15
PD14.Signal=FMC_D0_DA0
PD15.Signal=FMC_D1_DA1
PD3.Signal=LTDC_G7
PD8.Signal=FMC_D13_DA13
PD9.Signal=FMC_D14_DA14
PE0.Signal=FMC_NBL0
PE1.Signal=FMC_NBL1
PE10.Signal=FMC_D7_DA7
PE11.Signal=FMC_D8_DA8
PE12.Signal=FMC_D9_DA9
PE13.Signal=FMC_D10_DA10
PE14.Signal=FMC_D11_DA11
PE15.Signal=FMC_D12_DA12
PE7.Signal=FMC_D4_DA4
PE8.Signal=FMC_D5_DA5
PE9.Signal=FMC_D6_DA6
PF0.Signal=FMC_A0
PF1.Signal=FMC_A1
PF10.Signal=LTDC_DE
PF11.Signal=FMC_SDNRAS
PF12.Signal=FMC_A6
PF13.Signal=FMC_A7
PF14.Signal=FMC_A8
PF15.Signal=FMC_A9
PF2.Signal=FMC_A2
PF3.Signal=FMC_A3
PF4.Signal=FMC_A4
PF5.Signal=FMC_A5
PF7.Signal=SPI5_SCK
PF9.Signal=SPI5_MOSI
PG0.Signal=FMC_A10
PG1.Signal=FMC_A11
PG10.Signal=LTDC_G3
PG11.Signal=LTDC_B3
PG12.Signal=LTDC_B4
PG13.Signal=GPIO_Output
PG15.Signal=FMC_SDNCAS
PG4.Signal=FMC_A14_BA0
PG5.Signal=FMC_A15_BA1
PG6.Signal=LTDC_R7
PG7.Signal=LTDC_CLK
PG8.Signal=FMC_SDCLK
