pierre-bouckson/GameGirl/firmware/Game/rocket/rocket_track.c

/* Circuit de Rocket Space, repris tel quel du projet exam2_stm32 (track.c) :
 * pour chaque ligne, colonnes du bord gauche et du bord droit de la route. */

#include "rocket.h"

const uint8_t rocket_edges[ROCKET_TRACK_LEN][2] = {
		{12, 50},
		{12, 50},
		{12, 50},
		{13, 50},
		{14, 49},
		{15, 49},
		{16, 48},
		{17, 48},
		{17, 48},
		{18, 47},
		{18, 46},
		{19, 46},
		{19, 45},
		{20, 45},
		{20, 45},
		{20, 44},
		{21, 43},
		{21, 43},
		{21, 43},
		{21, 42},
		{21, 42},
		{21, 41},
		{21, 41},
		{21, 41},
		{21, 40},
		{21, 40},
		{21, 40},
		{21, 40},
		{21, 40},
		{21, 41},
		{22, 41},
		{22, 41},
		{22, 41},
		{22, 41},
		{22, 41},
		{22, 42},
		{22, 42},
		{22, 42},
		{22, 42},
		{23, 42},
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
};
