pierre-bouckson/GameGirl/firmware/Game/puissance4/puissance4.h

#ifndef __PUISSANCE4_H
#define __PUISSANCE4_H

/* Lance le Puissance 4 (choix Bot / 2 player, puis partie). Bloquant :
 * retourne au menu GameGirl quand la partie est finie et que le bouton est appuyé. */
void menu_puissance4(void);

#endif /* __PUISSANCE4_H */
