pierre-bouckson/GameGirl/firmware/Game/tetris/shape.c

#include "tetris.h"

/* Les 7 tétrominos, chacun dans une grille 4x4 : 1 = case pleine, 0 = vide.
 * Ordre : I, O, T, S, Z, J, L (voir shape_id_t) */
const uint8_t shapes[NB_SHAPES][SHAPE_SIZE][SHAPE_SIZE] =
{
    /* I */
    {
        {0, 0, 0, 0},
        {1, 1, 1, 1},
        {0, 0, 0, 0},
        {0, 0, 0, 0},
    },
    /* O */
    {
        {0, 1, 1, 0},
        {0, 1, 1, 0},
        {0, 0, 0, 0},
        {0, 0, 0, 0},
    },
    /* T */
    {
        {0, 1, 0, 0},
        {1, 1, 1, 0},
        {0, 0, 0, 0},
        {0, 0, 0, 0},
    },
    /* S */
    {
        {0, 1, 1, 0},
        {1, 1, 0, 0},
        {0, 0, 0, 0},
        {0, 0, 0, 0},
    },
    /* Z */
    {
        {1, 1, 0, 0},
        {0, 1, 1, 0},
        {0, 0, 0, 0},
        {0, 0, 0, 0},
    },
    /* J */
    {
        {1, 0, 0, 0},
        {1, 1, 1, 0},
        {0, 0, 0, 0},
        {0, 0, 0, 0},
    },
    /* L */
    {
        {0, 0, 1, 0},
        {1, 1, 1, 0},
        {0, 0, 0, 0},
        {0, 0, 0, 0},
    },
};
