pierre-bouckson/GameGirl/(commit log)

2026-09-27 Add STM32F429 firmware project with RGB565 color defines
    CubeMX project (LTDC, SPI5, I2C1) for the GameGirl display, with
    COLOR_* defines and an RGB565() macro in main.c. Build output ignored.
2026-09-28 Move framebuffer to external SDRAM via FMC bank 2
    - Enable FMC SDRAM bank 2 (SDCKE1/SDNE1, 12-bit address, 16-bit data,
    4 banks, CAS 3) for the IS42S16400J on the F429I-Discovery
    - Disable I2C1 (PB6 conflicts with SDNE1), enable I2C3 instead
    - Add SDRAM_InitSequence() sending the JEDEC init commands and
    programming the refresh rate (980 @ 64 MHz SDCLK)
    - Framebuffer is now a pointer to 0xD0000000 instead of a 150 KB
    array in internal SRAM
2026-09-28 Add double buffering with two framebuffers in SDRAM
    - framebuffer_1 at 0xD0000000, framebuffer_2 right after it
    (0xD0025800, 240*320*2 bytes further)
    - Draw into the back buffer, then swap on vertical blanking with
    HAL_LTDC_SetAddress_NoReload + HAL_LTDC_Reload to avoid tearing
    - Button now cycles through 4 colors, alternating buffers
    [main.c]
2026-09-29 Add display engine, 8x8 font, menu, ADC joystick and UART printf
    - Engine/: display module (RGB565 colors, double-buffered framebuffers,
    pixel/char/string drawing, vblank swap) and 8x8 ASCII font table
    - Game/menu: text-grid menu rendered with the font
    - ADC1 on PA5 (IN5) and PC3 (IN13) for the joystick, read per channel
    - USART1 at 115200 with printf redirected via __io_putchar
    - Makefile: build Engine/ and Game/*/ sources and include dirs
    [GameGirl.ioc, main.c]
2026-09-30 Read joystick via ADC DMA and add game selection to menu
    - ADC1 scans channels 5 (X) and 13 (Y) in continuous mode, results
    written by DMA2 Stream0 (circular) into joy_adc[2]
    - Add input module: joy_mv_t and selection_joy() with a dead zone
    to turn raw ADC values into a -1/0/1 direction
    - Menu: add Snake/Pong choice line and highlight the selected game
    - Main loop redraws the menu only when the joystick direction changes
2026-10-01 Redesign menu as a colored ASCII grid with 2D game selection
    The menu stays a 30x40 character grid, now with a block-letter title,
    one framed tile per game with a small icon, and per-zone coloring:
    title '#' and icon letters are drawn as solid color cells, and the
    selected tile gets an accent-colored frame and name bar. Games are
    picked on a 2x2 grid with both joystick axes.
    Also fix the selection state being redeclared as a shadowed,
    uninitialized local in the main loop, which garbled the menu on the
    first joystick move.
    [main.c]
2026-10-01 Read PA0 button through EXTI0 interrupt
2026-10-01 Add Rocket Space game and a fifth menu tile
    Port of the STM32F0 exam racing game: the original 64-column scrolling
    terminal is emulated and drawn with 3 px columns. The joystick Y axis sets
    the rocket position and holding PA0 boosts speed.
    The menu gets a centered Rocket tile on a third row; tiles are compacted to
    6 rows and joystick navigation becomes relative (one row per tilt).
2026-10-01 Add Connect 4 game ported from puissance_4_cpp
    C port of the terminal Connect 4 (Bot / 2 player modes, easy AI) with the
    same ASCII look. Launched with menu_puissance4() from the Puissance4 menu
    tile when the PA0 button is pressed; the joystick moves the column.
2026-10-03 Read joystick through get_joy and detect new moves in input engine
    selection_joy now takes a joy_mv_t from get_joy(), and new_selection()
    replaces the last-selection tracking that main.c did by hand. joy_adc is
    declared in input.h so the engine and games can read it.
    [main.c, p4_ihm.c]
2026-10-03 Add 2048 game skeleton with colored ASCII grid
    print_grid() draws the 4x4 board with per-value tile colors. The game
    loop spawns a 2 or 4 on each joystick move until PA0 is pressed;
    table_shift() is still empty.
2026-10-04 Read joystick inside selection_joy and filter ADC noise in new_selection
    selection_joy() and new_selection() now read joy_adc themselves.
    new_selection() compares directions instead of raw ADC values, so noise
    inside the dead zone (now JOY_DEADZONE) no longer reports a new move.
    [main.c]
2026-10-04 Add score, flash-saved best score, game over and merge animation to 2048
    - Tiles slide and merge in the joystick direction; a new tile (4 with 10%
    odds) spawns only when the board changed
    - Score counts merged values; best score is kept in flash sector 23
    - Game over screen when no move is left
    - Merged tiles briefly pop over their borders
2026-10-06 Add Tetris game and a sixth menu tile
    Tetris on a 10x20 board drawn as 16 px blocks with a grid, an info panel
    (score, level, lines, best, next piece) and a dedicated game over screen.
    Pieces come from a 7-bag, rotate with wall kicks, soft-drop with the
    joystick, and the fall speeds up every 10 lines. The best score is saved
    in flash sector 21. Rocket moves next to Tetris on the menu's third row.
    Also add CLAUDE.md with build and architecture notes.
2026-11-11 Add GameGirl PCB (KiCad, 4 layers), JLCPCB production files and 3D-printable case
    - PCB: 74 x 122 mm Game Boy form factor, routed, with project libraries,
    layout scripts and JLCPCB gerbers/BOM/CPL
    - Mechanical reference for the case (MECANIQUE_BOITIER.md)
    - Case: CadQuery model with STL/STEP exports, sized for a 503450 LiPo
